johangroth/PLUTO/README.md

#PLUTO --- A WDC65C02 based Single Board Computer ---#

###Links to inspirational projects###
