johangroth/PLUTO/doc/pluto.odt

Pluto ACE

A 65C02 SBC by Johan Groth

## Introduction

This is my first SBC project which is based on a 65C02 MPU. I got inspired building my own computer by finding a paper I wrote in collage about 35 years ago with pretty much the same idea, build a computer from scratch. That work was in turn based on my experiences with my still favourite computer, the Commodore 64 (still got one, now with a 60GB hard drive, thanks to the IDE64 project and an REU thanks to the 1541 Ultimate II+ project).

Back then I didn't have the resources (regulated power supply, oscilloscope, soldering station, a high quality multi meter, etc) and definitely not the money to build one so the paper became a theoretical computer I never built. Now, 35 years later I actually got the resources needed to build one and to my surprise the 65C02 is still in production (thank you WDC) together with the most common support/io ICs, the VIA 65C22 and the ACIA 65C51. Add some static RAM and an EEPROM and you got a computer that can interface with the world through the VIA and be controlled over the serial line via the ACIA.

Another inspiration is a little known computer that saw the light of day in early eighties called the Jupiter ACE. It had the capabilities of a ZX-81, if not less but you didn't need a hammer and a chisel to type anything as it had a rubber membrane keyboard like the ZX Spectrum. What was special with the Jupiter ACE compared to the rest of all 8-bit computer from the eighties was that it didn't use BASIC as its OS, but Forth. That intrigued me a lot back then but all my friends had a Commodore 64 so that is what I got as well.

My original Commodore 64 is long gone, so I bought one from Ebay and it works just fine and IMHO with the IDE64 interface and a modern hard drive it is a nice computer system. It didn't come with any software though (not that I wanted any) so I had to search the internet for assemblers, tools and some games and while doing that I stumbled on the web-site http://6502.org/ which has forums about SBCs, 6502 assembler routines etc, and a Forth forum.

So I thought, why not build something similar to the Jupiter ACE computer. Same MPU, better I/O, more memory, a serial interface, no video though as I don't know anything about video, so for this project composite video or CGA (half VGA) is out of scope from the very beginning. So I started to research how the Jupiter ACE works and found a big snag. The Jupiter ACE is based on a Z80 MPU and I know nothing about that MPU and learning a new hardware architecture is too much of a hassle. So I decided to build an SBC based on a 65C02 and using Forth as it's OS.

Ambitious, yes!

Impossible, no!

# Goals, both hardware and software

Hardware:

- An WDC65C02
- An ACIA (I chose the R65C51AE4 as the WDC65C51 has a hardware bug which makes transmission difficult to implement.)
- One VIA WDC65C21
- 32KB of RAM
- 32KB of ROM
- 16-bit IDE interface
- RTC DS1511Y
- Box to house it. Must be something retro, like a radio from the forties (inspired by the Veronica project).
- VT100 terminal interface.

Software:

- Tali Forth with an integrated full screen editor over serial line, so a fully compliant VT100 terminal that can render Escape sequences will be a requirement.
- PLUTO OS which will use Tali Forth, so for example, creating multiple directories will be something like mkdir “dir1/dir2/dir3”.
- CFS which is the file system IDEDOS project has created. Right now it is bespoke to the IDE64 project but the software is GPL so anyone can use it and it should be possible to adapt it to another hardware platform. I want it so I can exchange files between the PLUTO system and the C64.

Personal:

- Learn a lot more about digital electronics (in some areas relearn what I once knew).
- KiCad because it is free and a Linux version exists.
- 65C02 assembly (I've forgotten so much from my Commodore 64 days).
- Learn Forth

# Architecture

Memory map PLUTO (Thank you Daryl Rictor for the decoding logic!)

Start | End | Description
$0000 | $7EFF | RAM (32K minus 256 bytes)
$7F00 | $7F1F | Decoded I/O Block (32 bytes)
$7F20 | $7F3F | Decoded I/O Block (32 bytes)
$7F40 | $7F5F | Decoded I/O Block (32 bytes)
$7F60 | $7F7F | Decoded I/O Block (32 bytes)
$7F80 | $7F9F | IDE interface (32 bytes)
$7FA0 | $7FBF | Real Time Clock, DS1511Y (32 bytes)
$7FC0 | $7FDF | VIA (32 bytes)
$7FE0 | $7FFF | ACIA (32 bytes)
$8000 | $FFFF | EEPROM (32K)

Memory map ACIA

RS1 | RS0 | R/W | Memory Position | Description
0 | 0 | 0 | $7FE0 | TxD
0 | 0 | 1 | $7FE0 | RxD
0 | 1 | 0 | $7FE1 | Programmed Reset
0 | 1 | 1 | $7FE1 | Read Status Register
1 | 0 | 0 | $7FE2 | Write Command Register
1 | 0 | 1 | $7FE2 | Read Command Register
1 | 1 | 0 | $7FE3 | Write Control Register
1 | 1 | 1 | $7FE3 | Read Control Register

Memory map VIA

Register Number | RS Coding | | | | Register Designation | Description
| RS3 | RS2 | RS1 | RS2 | | Write/Read
0 | 0 | 0 | 0 | 0
1 | 0 | 0 | 0 | 1
2 | 0 | 0 | 1 | 0
3 | 0 | 0 | 1 | 1
4 | 0 | 1 | 0 | 0
5 | 0 | 1 | 0 | 1
6 | 0 | 1 | 1 | 0
7 | 0 | 1 | 1 | 1
8 | 1 | 0 | 0 | 0
9 | 1 | 0 | 0 | 1
A | 1 | 0 | 1 | 0
B | 1 | 0 | 1 | 1
C | 1 | 1 | 0 | 0
D | 1 | 1 | 0 | 1
E | 1 | 1 | 1 | 0
F | 1 | 1 | 1 | 1

RS-232 pin layout

Signal abbreviation | Meaning | Signal direction at DTE UART | Logic | DB-9 pin number (standard) | R6551 (DIP) pin
GND | Signal ground | | | 5 | 1
TxD | Transmitted data | Output | Positive | 3 | 10
RxD | Received data | Input | Positive | 2 | 12
RTS | Request to send | Output | Negative | 7 | 8
CTS | Clear to send | Input | Negative | 8 | 9
DTR | Data terminal ready | Output | Negative | 4 | 11
DSR | Data set ready | Input | Negative | 6 | 17
DCD | Data carrier detect | Input | Negative | 1 | 16

# DOS

From the experience collected with the above prototype software, I went on with the idea of writing a multi layer operating environment (OSS) for the HDD :

- 1st layer : low level routines - init device, read / write sectors - written in assembler
- 2nd layer : disk structure analysis - master boot record -> find the partition table, boot parameter block -> find CFS and its main structures - written in assembler
- 3rd layer : CFS structure navigation - written in assembler.
- 4th layer : small and efficient user services - save / load / execute, navigate in directory tree - written in Forth

# Schematics

# Construction

## PCB

## Mechanical
