johangroth/PLUTO/SBC/pluto.pdf

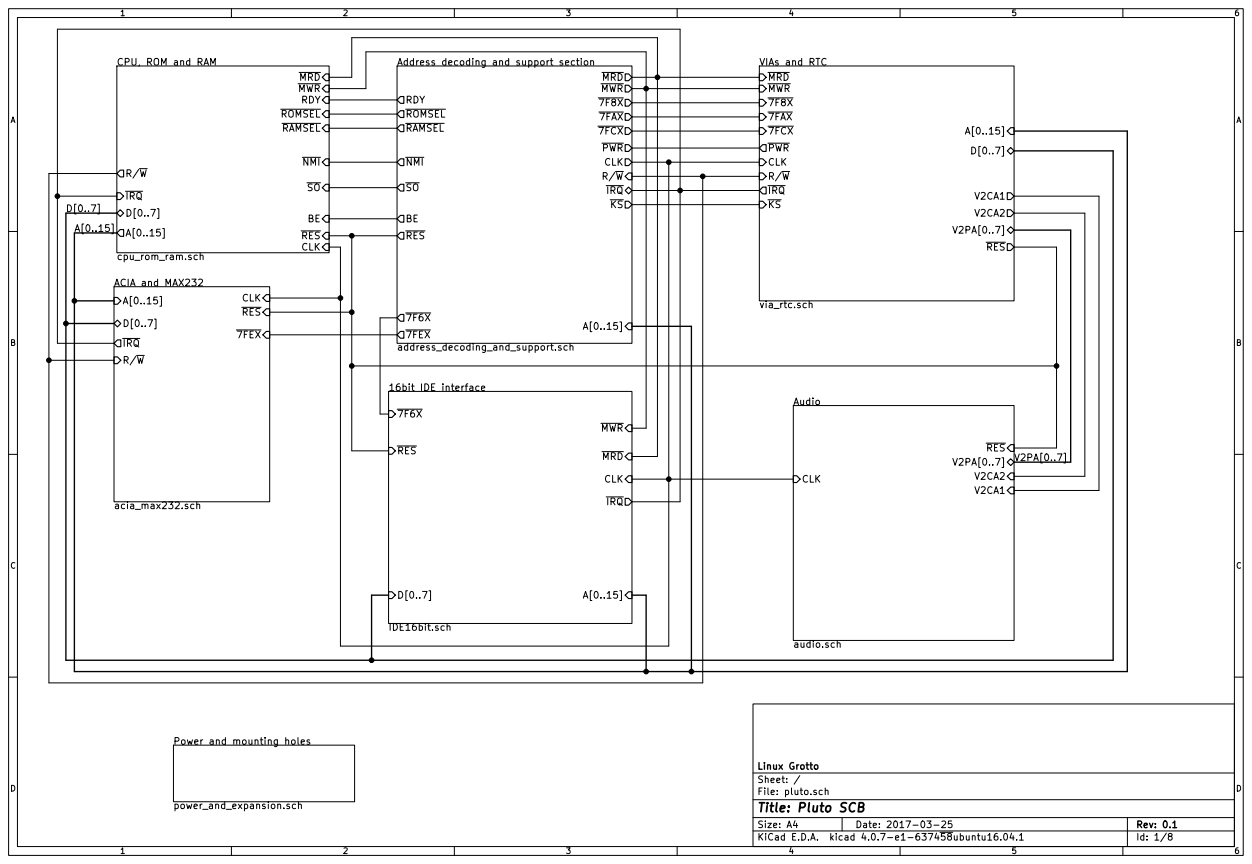
[picture p1: page 1]

CPU, ROM and RAM

Address decoding and support section
RDY RES
ROMSEL
RAMSEL

NMI CLK MRD MWR

Power and mounting holes

File: pluto.sch Sheet: / Linux Grotto

Id: 1/8 Title: Pluto SCB

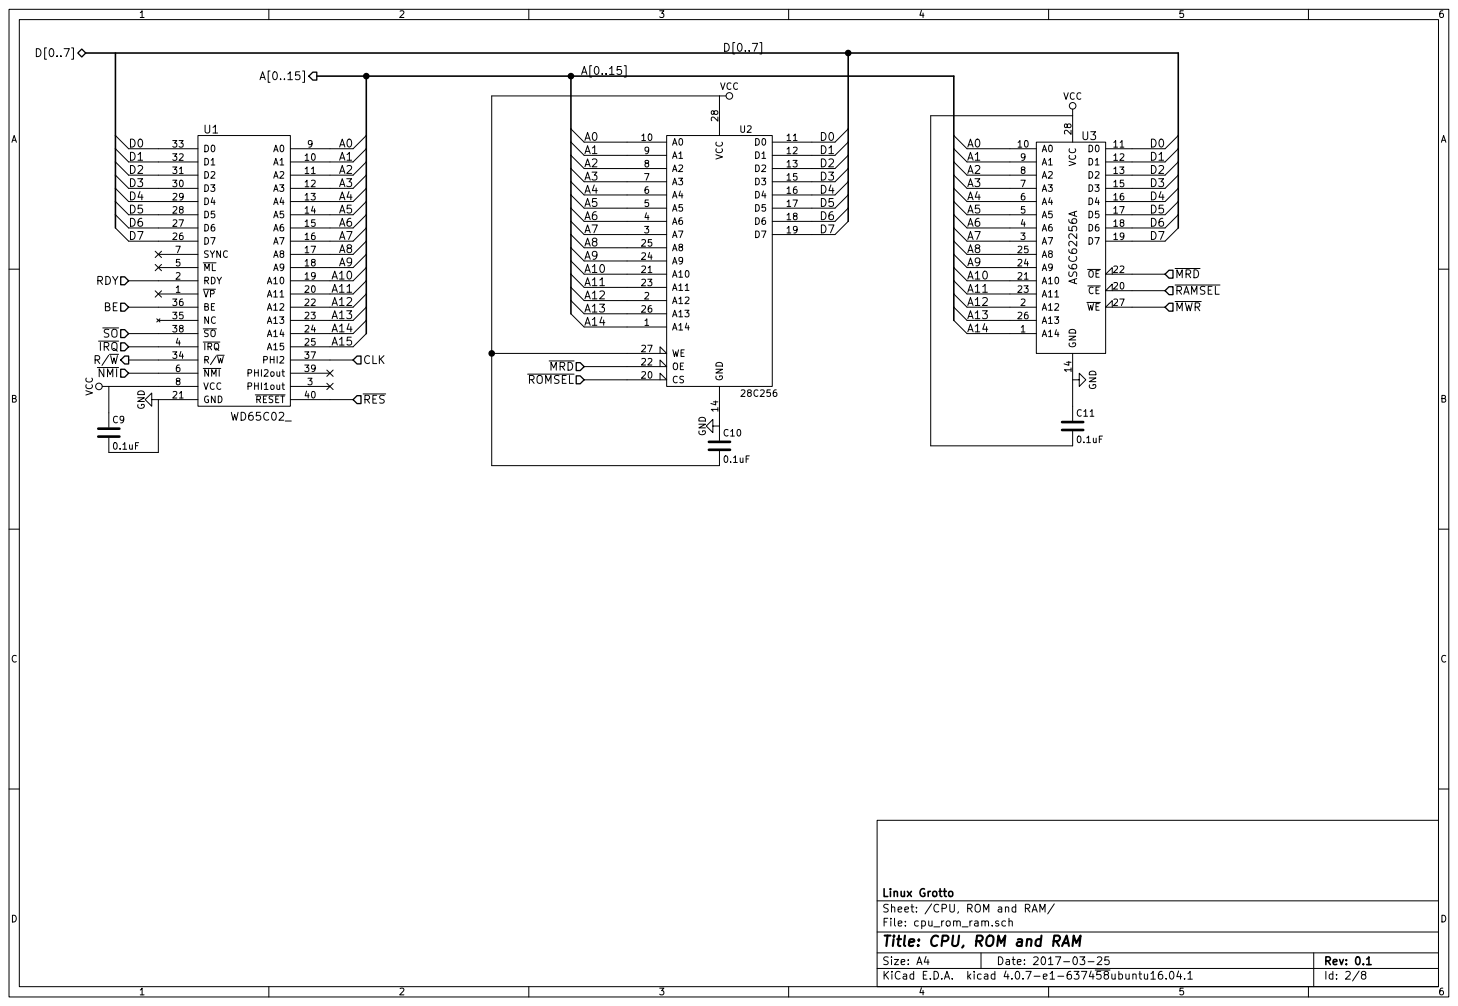
[picture p2: page 2]

Sheet: /CPU, ROM and RAM/ Linux Grotto

File: cpu_rom_ram.sch
Id: 2/8 Title: CPU, ROM and RAM

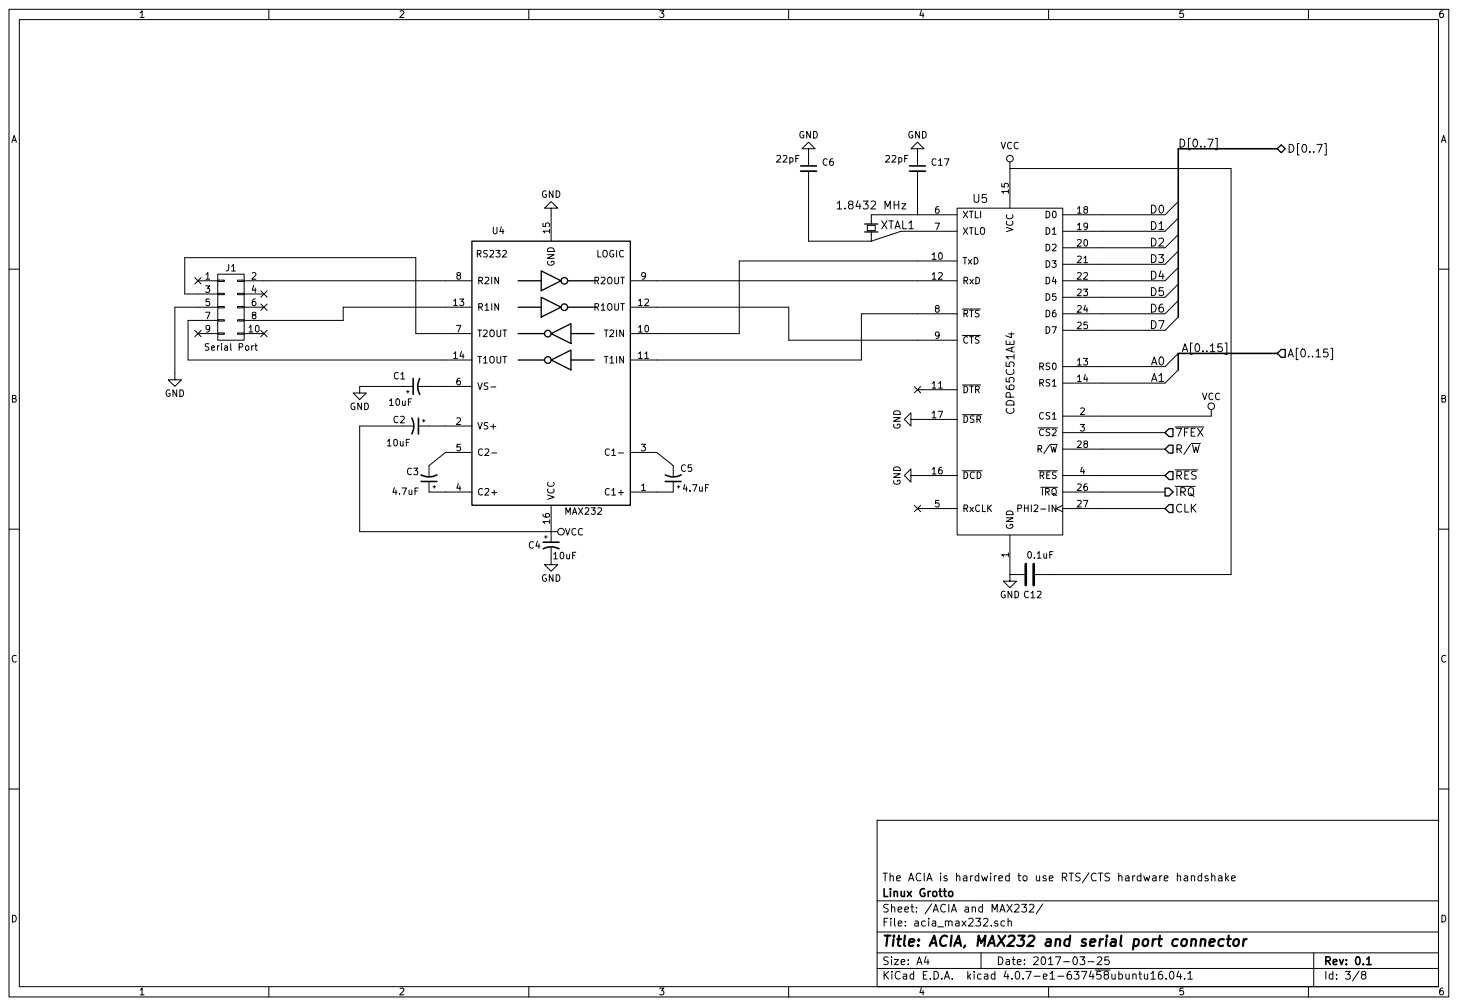
[picture p3: page 3]

1 CS1 2 CS2 3 RES 4 RxCLK 5 XTLI 6 XTLO 7 RTS 8 CTS 9 TxD 10 D2 20 DTR 11 D3 21 RxD 12 D4 22 RS0 13 D5 23 RS1 14 D6 24 VCC 15 D7 25 DCD 16

The ACIA is hardwired to use RTS/CTS hardware handshake GND

File: acia_max232.sch Sheet: /ACIA and MAX232/ Linux Grotto

Id: 3/8 Title: ACIA, MAX232 and serial port connector

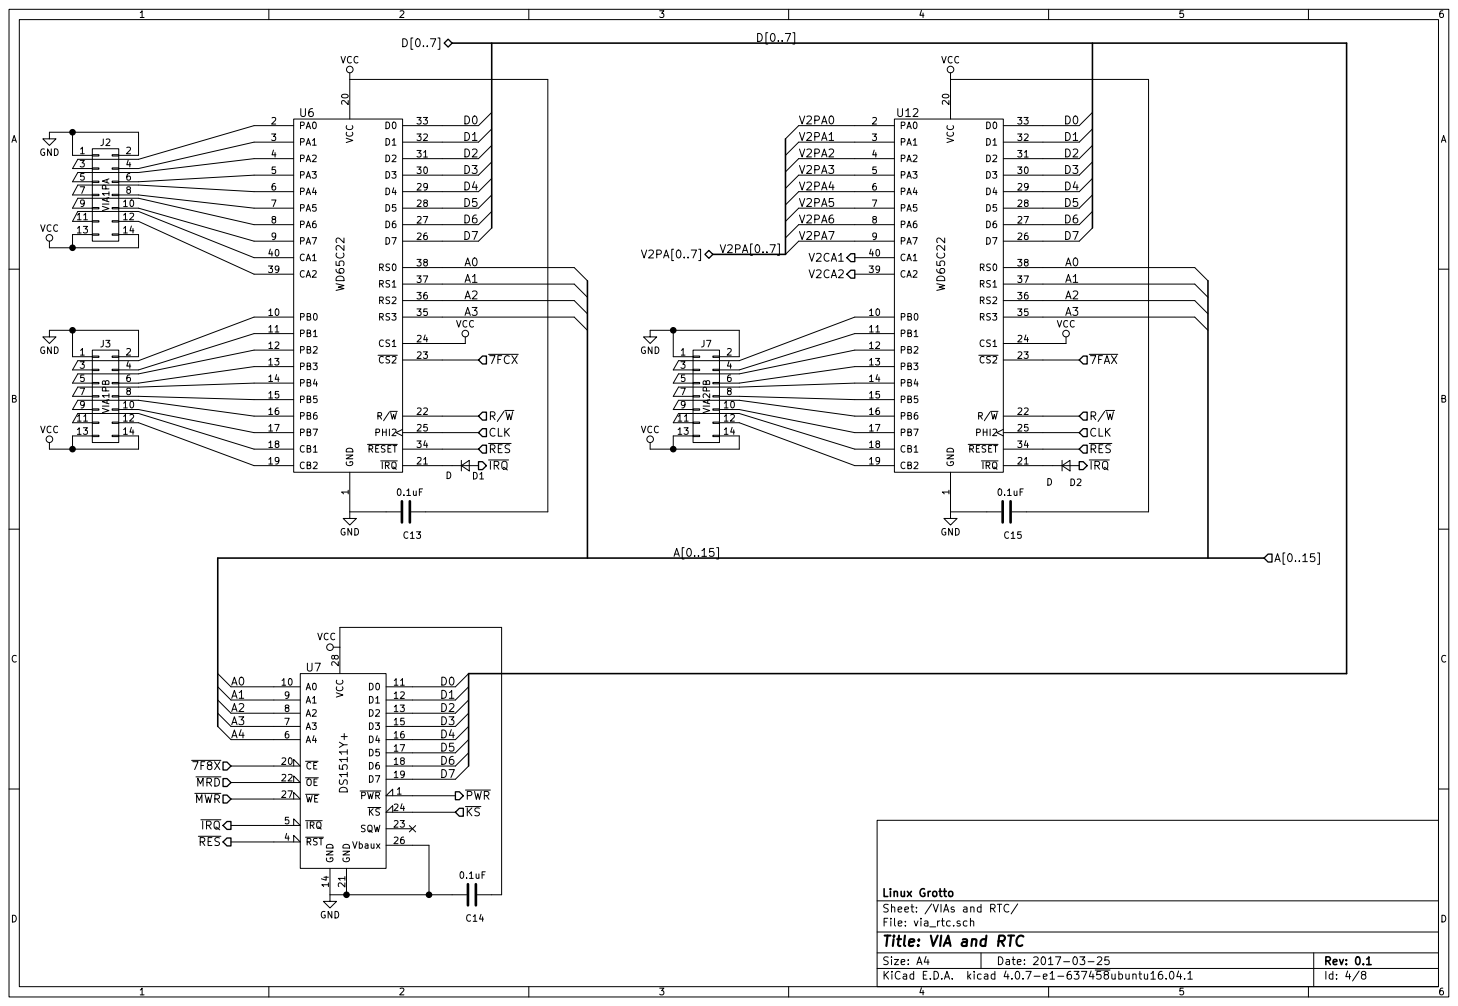
[picture p4: page 4]

Id: 4/8 Title: VIA and RTC

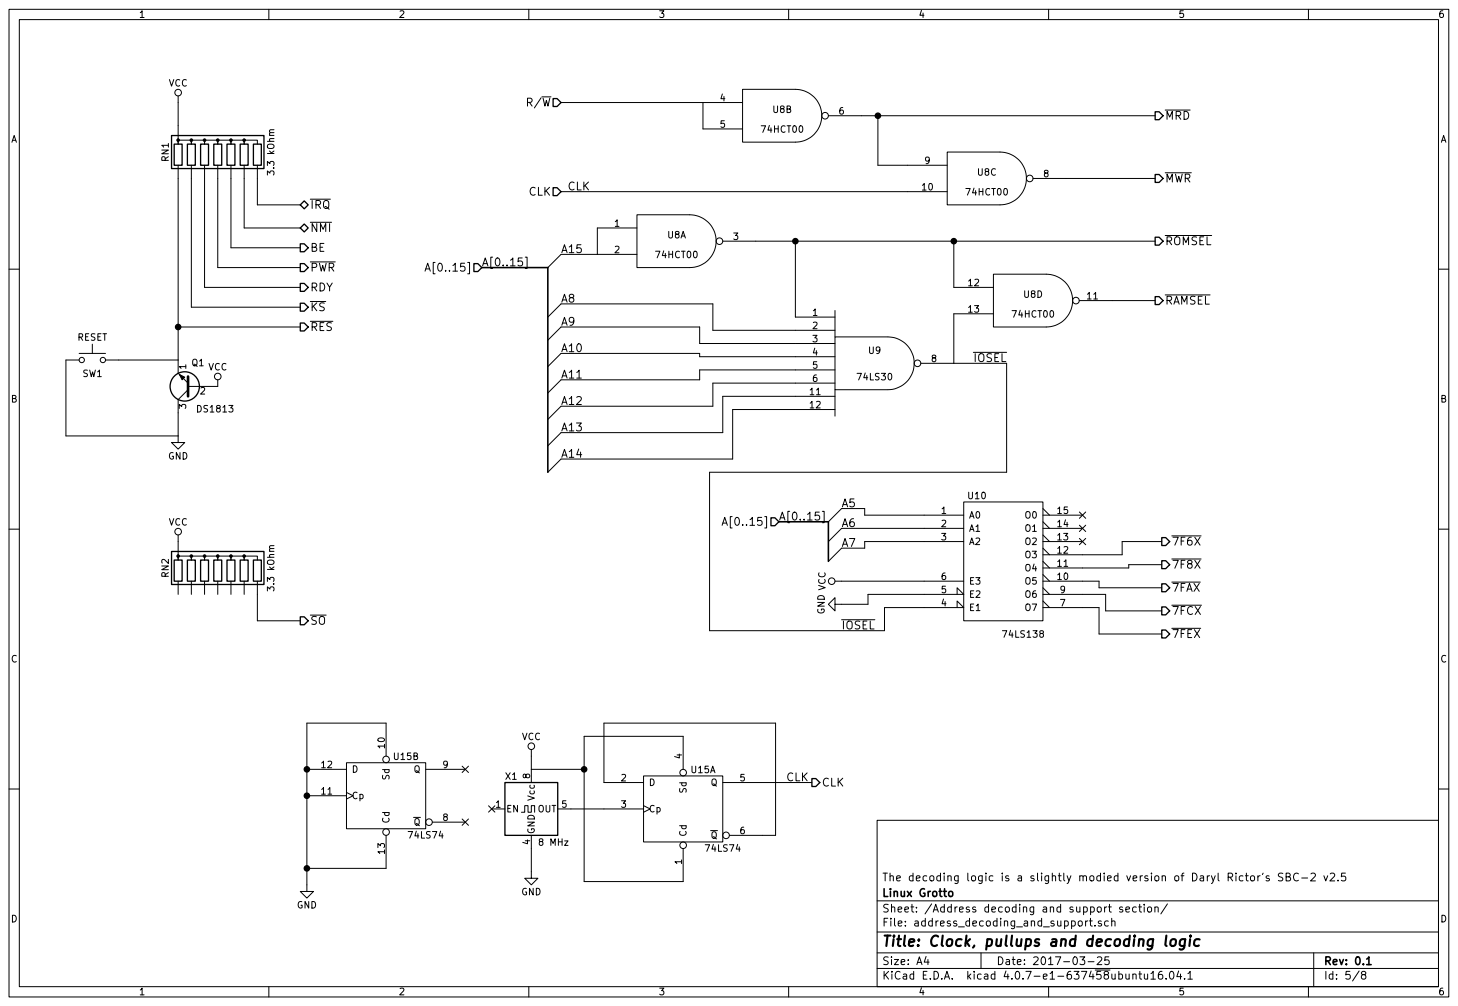
[picture p5: page 5]

3 Q1DS1813 VCC SW1 RESET GND VCC GND Cd

The decoding logic is a slightly modied version of Daryl Rictor's SBC-2 v2.5
Sheet: /Address decoding and support section/ Linux Grotto

File: address_decoding_and_support.sch
Id: 5/8 Title: Clock, pullups and decoding logic

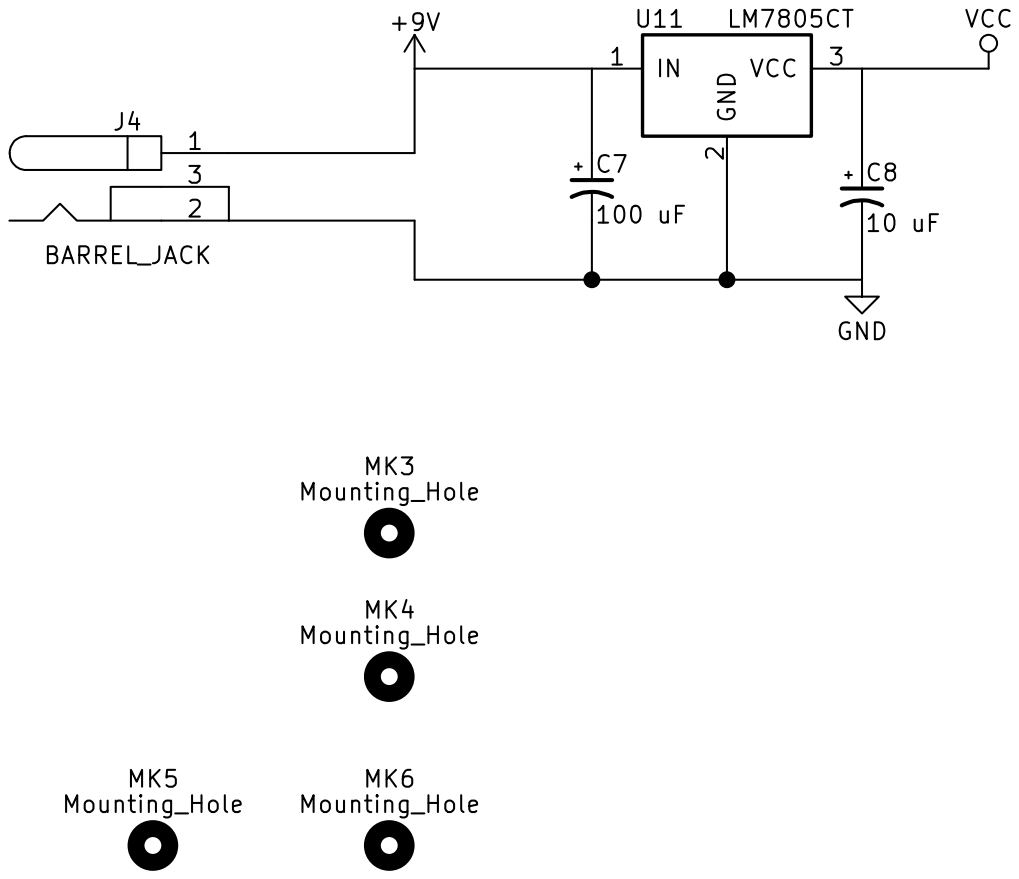
[picture p6: page 6]

Sheet: /Power and mounting holes/ Linux Grotto

File: power_and_expansion.sch
Id: 6/8 Title: Power supply and mounting holes

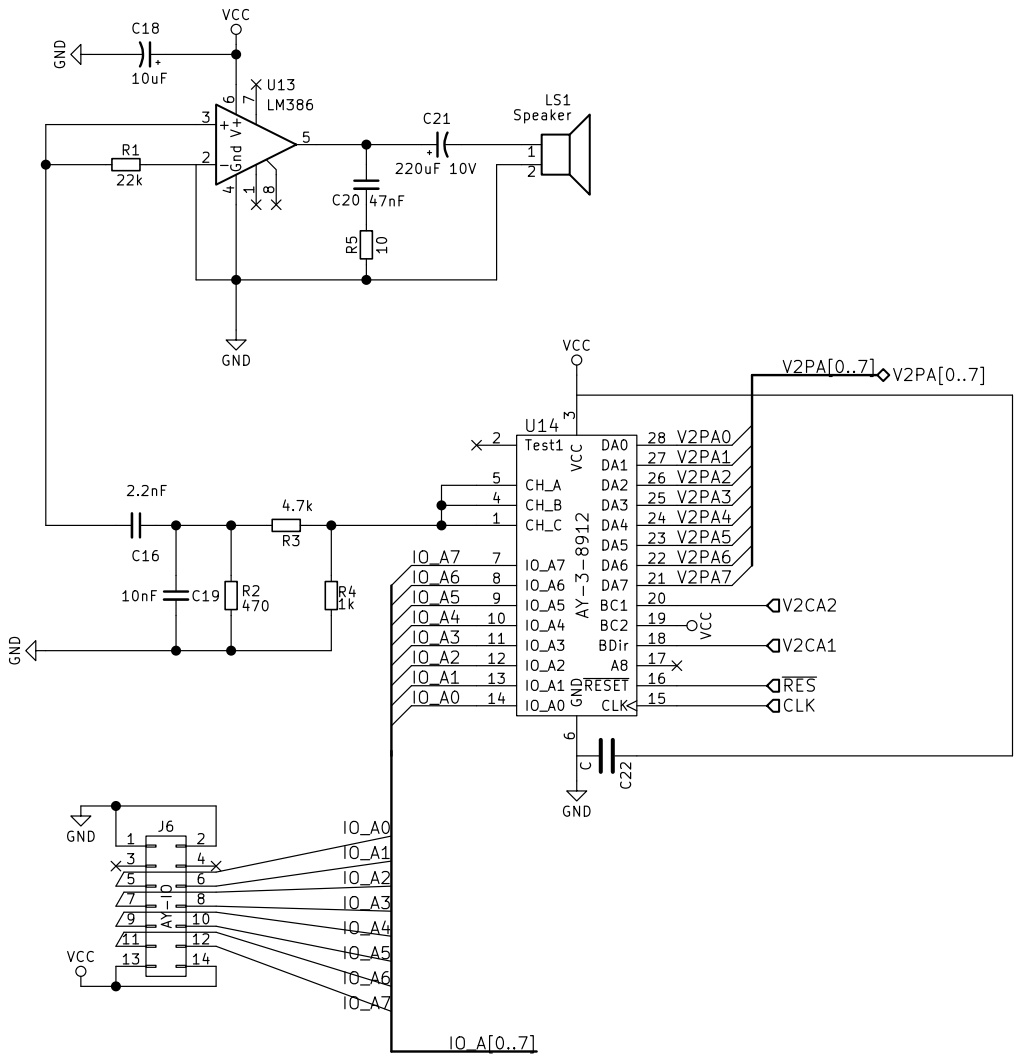
[picture p7: page 7]

File: audio.sch Sheet: /Audio/
Id: 7/8 Title: Audio

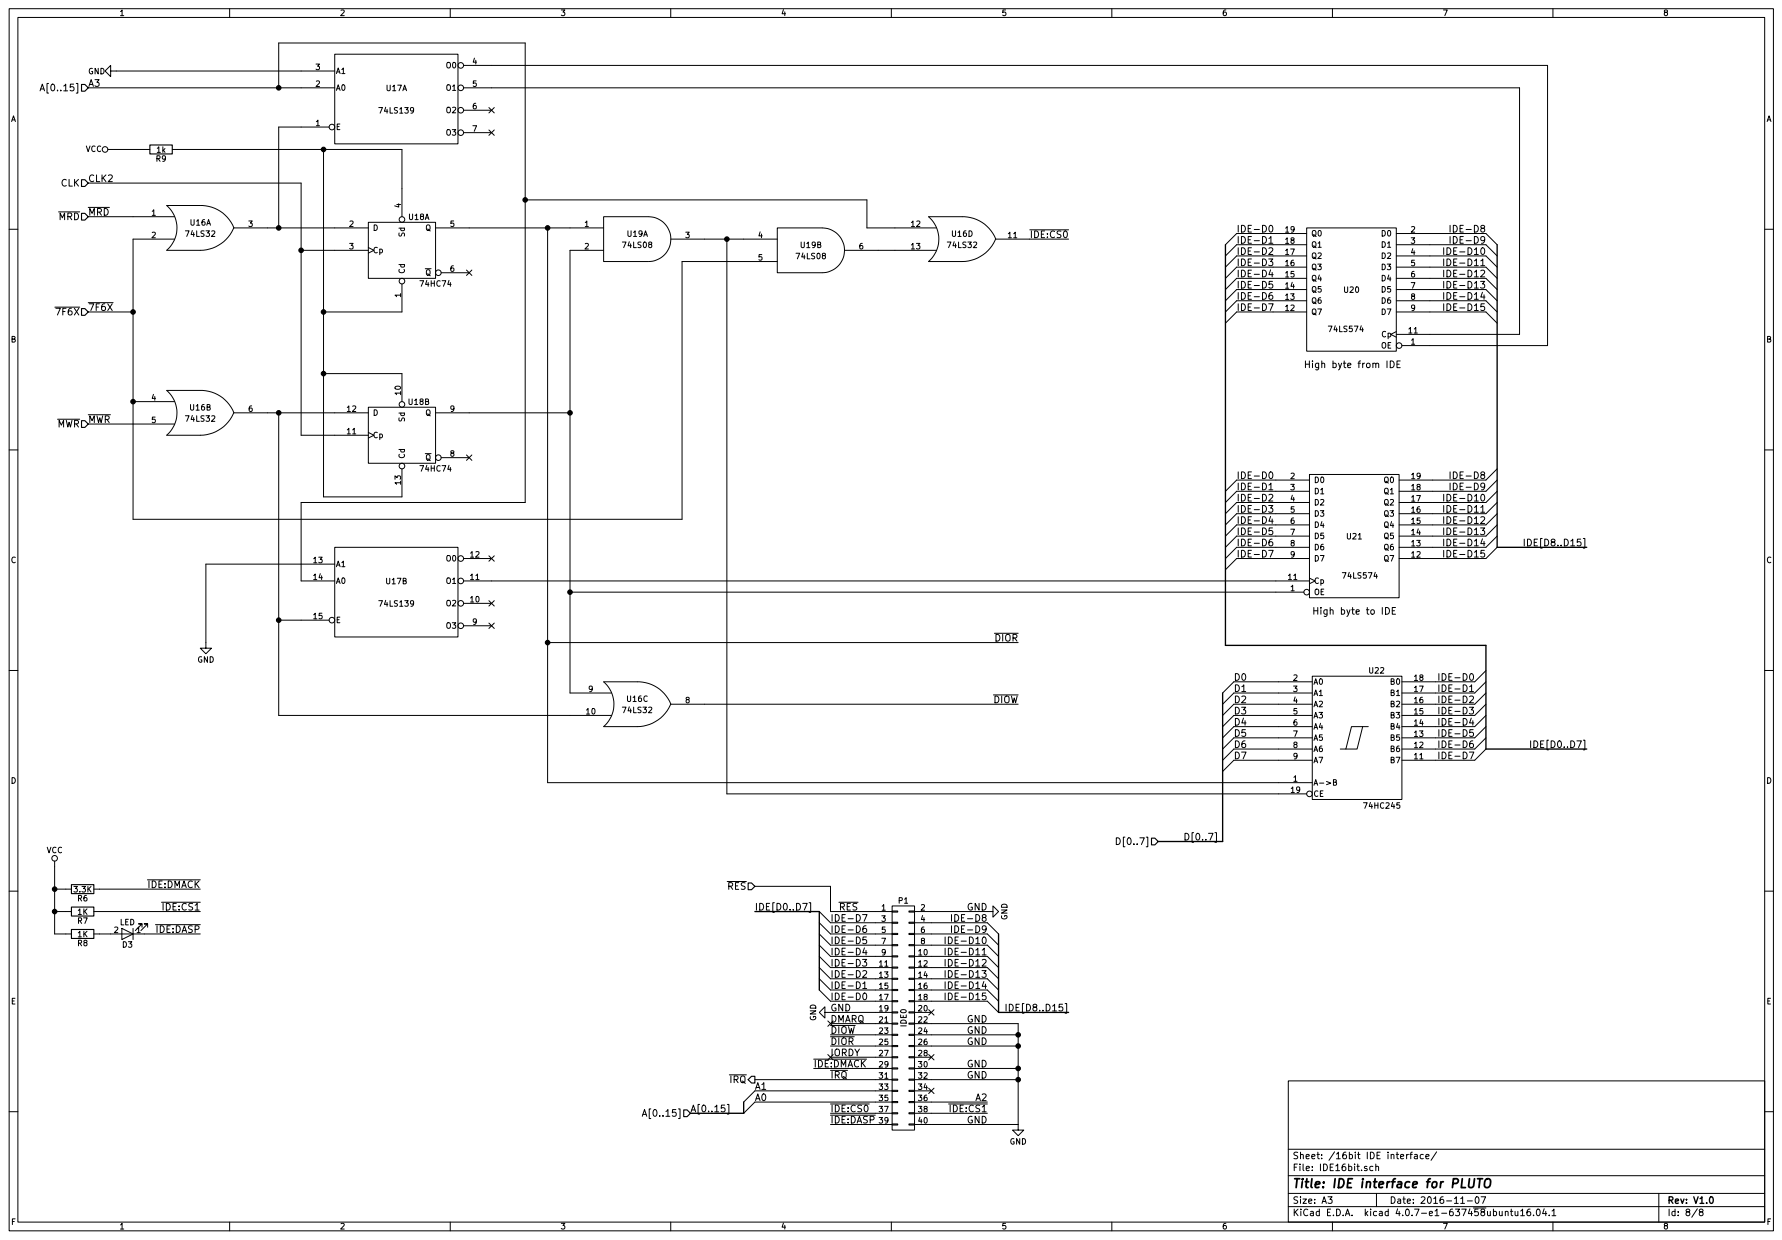
[picture p8: page 8]

IDE:CS0 DIOR
High byte from IDE High byte to IDE

Id: 8/8 Title: IDE interface for PLUTO
