johangroth/PLUTO/(list of files, drawings)

Other design files:
SBC/pluto.dsn
