johangroth/PLUTO/SW/PlutoDos/pluto_kernel.asm

;
;
;***************************************************
;* S/O/S SyMon III (c)1990,2007 By Brian M. Phelps *
;*                                                 *
;*         BIOS, Monitor, Micro-assembler          *
;*           For the 6502/65c02 family             *
;*         of microprocessor units (MPU)           *
;*                                                 *
;*   Includes text editor, text and byte string    *
;*  search utility, data upload/download utility   *
;*                                                 *
;*              Version 06/07/07                   *
;*                                                 *
;*          (Requires 8kb of memory)               *
;***************************************************
;

;16 byte buffer
    SRCHBUFF = $00F0    ;16 bytes ($F0-$FF) (notice that this variable MUST be expressed as a 16 bit address
;                        even though it references a zero-page address)
;
;Keystroke input buffer address:
    KEYBUFF  = $0200    ;256 bytes: ($200-$2FF) keystrokes (data from ACIA) are stored here
                       ; by SyMon's IRQ service routine.

;
;
;Interrupt vectors. User can change the interrupt vector by putting a new value at this address.
    INTERRUPTVECTORS    = $0300
    NMIVECTOR           = INTERRUPTVECTORS
    IRQVECTOR           = INTERRUPTVECTORS+2
    BREAKVECTOR         = INTERRUPTVECTORS+4
    VIATIMER1VECTOR     = INTERRUPTVECTORS+6
    VIATIMER2VECTOR     = INTERRUPTVECTORS+8
    ACIAVECTOR          = INTERRUPTVECTORS+10
;
;
;***************
;* Subroutines *
;***************
;
;ASC2BN subroutine: Convert 2 ASCII HEX digits to a binary (byte) value.
; Enter: ACCUMULATOR = high digit, Y-REGISTER = low digit
; Returns: ACCUMULATOR = binary value
ASC2BN  .proc
        PHA           ;Save high digit on STACK
        TYA           ;Copy low digit to ACCUMULATOR
        JSR  BINARY   ;Convert digit to binary nybble: result in low nybble
        STA  TEMP     ;Store low nybble
        PLA           ;Pull high digit from STACK
        JSR  BINARY   ;Convert digit to binary nybble: result in low nybble
        ASL        ;Move low nybble to high nybble
        ASL
        ASL
        ASL
        ORA  TEMP     ;OR high nybble with stored low nybble
        RTS           ;Done ASC2BN subroutine, RETURN
BINARY:
        SEC           ;Clear BORROW
        SBC  #$30     ;Subtract $30 from ASCII HEX digit
        CMP  #$0A     ;GOTO BNOK IF result < $0A
        BCC  BNOK
        SBC  #$07     ; ELSE, subtract $07 from result
BNOK:
        RTS           ;Done BINARY subroutine, RETURN
        .pend
;
;ASCTODEC subroutine: convert ASCII DECIMAL digits to BCD
ASCTODEC    .proc         ;Initialize (zero) BCD digit input buffer:
        STZ  DEC0AND1 ; two most significant BCD digits
        STZ  DEC2AND3
        STZ  DEC4AND5
        STZ  DEC6AND7
        STZ  DEC8AND9 ; two least significant BCD digits
        LDX  BUFIDX   ;Read number of digits entered: ASCII digit buffer index
        BEQ  A2DDONE  ;GOTO A2DDONE IF BUFIDX = 0: no digits were entered
        LDY  #$05     ; ELSE, Initialize BCD input buffer index: process up to 5 BCD bytes (10 digits)
ATODLOOP:
        JSR  A2DSUB   ;Read ASCII digit then convert to BCD
        STA  DPHANTOM,Y ;Write BCD digit to indexed buffer location (index always > 0)
        JSR  A2DSUB   ;Read ASCII digit then convert to BCD
        ASL        ;Make this BCD digit the more significant in the BCD byte
        ASL
        ASL
        ASL
        ORA  DPHANTOM,Y ;OR with the less significant digit
        STA  DPHANTOM,Y ;Write BCD byte to indexed buffer location (index always > 0)
        DEY           ;Decrement BCD input buffer index
        BNE  ATODLOOP ;GOTO ATODLOOP IF buffer index <> 0: there is room to process another digit
A2DDONE:
        RTS           ; ELSE, done ASCTODEC, RETURN
        .pend

;Read indexed ASCII DECIMAL digit from text buffer then convert digit to 4 bit BCD
A2DSUB  .proc
        TXA           ;GOTO A2DCONV IF digit buffer index <> 0: there are more digits to process
        BNE  A2DCONV
        PLA           ; ELSE, pull return address from STACK
        PLA
        RTS           ;Done ASCTODEC, RETURN
A2DCONV:
        LDA  INBUFF-1,X ;Read indexed ASCII DECIMAL digit
        SEC           ;Subtract ASCII "0" from ASCII DECIMAL digit: convert digit to BCD
        SBC  #$30
        DEX           ;Decrement ASCII digit buffer index
        RTS           ;A2DSUB done, RETURN
        .pend
;
;BCDOUT subroutine: convert 10 BCD digits to ASCII DECIMAL digits then send result to terminal.
;Leading zeros are supressed in the displayed result.
;Call with 10 digit (5 byte) BCD value contained in variables DEC0AND1 through DEC8AND9:
;DEC0AND1 ($E5) Two most significant BCD digits
;DEC2AND3 ($E6)
;DEC4AND5 ($E7)
;DEC6AND7 ($E8)
;DEC8AND9 ($E9) Two least significant BCD digits
BCDOUT  .proc
        LDX  #$00     ;Initialize BCD output buffer index: point to MSB
        LDY  #$00     ;Initialize leading zero flag: no non-zero digits have been processed
BCDOUTL
        LDA  DEC0AND1,X ;Read indexed byte from BCD output buffer
        LSR        ;Shift high digit to low digit, zero high digit
        LSR
        LSR
        LSR
        JSR  BCDTOASC ;Convert BCD digit to ASCII DECIMAL digit, send digit to terminal
        LDA  DEC0AND1,X ;Read indexed byte from BCD output buffer
        AND  #$0F     ;Zero the high digit
        JSR  BCDTOASC ;Convert BCD digit to ASCII DECIMAL digit, send digit to terminal
        INX           ;Increment BCD output buffer index
        CPX  #$05
        BNE  BCDOUTL  ;LOOP back to BCDOUTL IF output buffer index <> 5
        CPY  #$00
        BNE  BCDOUTDN ; ELSE, GOTO BCDOUTDN IF any non-zero digits were processed
        LDA  #$30     ; ELSE, send "0" to terminal
        JSR  COUT
BCDOUTDN
        RTS           ;Done BCDOUT subroutine, RETURN
        .pend

;BCDTOASC subroutine:
; convert BCD digit to ASCII DECIMAL digit, send digit to terminal IF it's not a leading zero
BCDTOASC    .proc
        BNE  NONZERO  ;GOTO NONZERO IF BCD digit <> 0
        CPY  #$00     ; ELSE, GOTO BTADONE IF no non-zero digits have been processed
        BEQ  BTADONE  ;  (supress output of leading zeros)
NONZERO
        INY           ; ELSE, indicate that a non-zero digit has been processed (Y REGISTER <> 0)
        CLC           ;Add ASCII "0" to digit: convert BCD digit to ASCII DECIMAL digit
        ADC  #$30
        JSR  COUT     ;Send converted digit to terminal
BTADONE
        RTS           ;Done BCDTOASC subroutine, RETURN
        .pend
;
;
;BEEP subroutine: Send ASCII [BELL] to terminal
BEEP    .proc
        PHA           ;Save ACCUMULATOR on STACK
        LDA  #$07     ;Send ASCII [BELL] to terminal
        JSR  COUT
        PLA           ;Restore ACCUMULATOR from STACK
        RTS           ;Done BEEP subroutine, RETURN
        .pend
;
;BN2ASC subroutine: Convert byte in ACCUMULATOR to two ASCII HEX digits.
; Returns: ACCUMULATOR = high digit, Y-REGISTER = low digit
BN2ASC  .proc
        TAX          ;Copy ACCUMULATOR to X-REGISTER
        AND  #$F0     ;Mask (zero) low nybble
        LSR        ;Move high nybble to low nybble: high nybble now = 0
        LSR
        LSR
        LSR
        JSR  ASCII    ;Convert nybble to an ASCII HEX digit
        PHA           ;Save high digit on STACK
        TXA           ;Restore ACCUMULATOR from X-REGISTER
        AND  #$0F     ;Mask (zero) high nybble
        JSR  ASCII    ;Convert nybble to an ASCII HEX digit
        TAY           ;Copy low digit to Y-REGISTER
        PLA           ;Pull high digit from STACK to ACCUMULATOR
        RTS           ;Done BN2ASC subroutine, RETURN
        .pend

ASCII   .proc
        CMP  #$0A     ;GOTO ASOK IF nybble < $A
        BCC  ASOK
        CLC           ; ELSE, clear CARRY
        ADC  #$07     ;ADD $07
ASOK:
        ADC  #$30     ;ADD $30
        RTS           ;Done BN2ASC or ASCII subroutine, RETURN
        .pend
;
;BSOUT subroutine: send [BACKSPACE] to terminal
BSOUT   .proc
        LDA  #$08     ;Send [BACKSPACE] to terminal
        BRA  COUT     ; then done BSOUT subroutine, RETURN
        .pend

;
;CHIN subroutine: Wait for a keystroke, return with keystroke in ACCUMULATOR
CHIN    .proc
        STX  TEMP     ;Save X REGISTER
CHINLOOP:
        CLI           ;Enable external IRQ response
        LDA  INCNT    ;(Keystroke buffer input counter)
        CMP  OUTCNT   ;(Keystroke buffer output counter)
        BEQ  CHIN     ;LOOP back to CHIN IF INCNT = OUTCNT: there are no keystrokes in buffer
        LDX  OUTCNT   ; ELSE, read indexed keystroke from buffer
        LDA  KEYBUFF,X
        INC  OUTCNT   ;Remove keystroke from buffer
        LDX  TEMP     ;Restore X REGISTER
        RTS           ;Done CHIN subroutine, RETURN
        .pend

;
;CHREG subroutine: Display HEX byte value in ACCUMULATOR, request HEX byte input from terminal
CHREG   .proc
        JSR  PRBYTE   ;Display HEX value of ACCUMULATOR
        JSR  SPC      ;Send [SPACE] to terminal
        JMP  HEXIN2   ;Request HEX byte input from terminal (result in ACCUMULATOR)
                      ; then done CHREG subroutine, RETURN
        .pend

;
;COUT subroutines: Send byte in ACCUMULATOR to terminal (1,2 or 3 times)
COUT3:  .proc
        JSR  COUT     ;(Send byte 3 times)
        .pend

COUT2:  .proc
        JSR  COUT     ;(Send byte 2 times)
        .pend

COUT    .proc
        PHA           ;Save ACCUMULATOR on STACK
COUTL:  LDA  SIOSTAT  ;Read ACIA status register
        AND  #$10     ;Isolate transmit data register status bit
        BEQ  COUTL    ;LOOP back to COUTL IF transmit data register is full
        PLA           ; ELSE, restore ACCUMULATOR from STACK
        STA  SIODAT   ;Write byte to ACIA transmit data register
        RTS           ;Done COUT subroutine, RETURN
        .pend

;
;DECINPUT subroutine: request 1 to 10 DECIMAL digits from terminal. Result is
; stored in zero-page address INBUFF through (INBUFF + $0A)
;Setup RDLINE subroutine parameters:
DECINPUT    .proc
        LDA  #$FF     ;  Allow only valid ASCII DECIMAL digits to be entered:
        STA  LOKOUT   ;   variable LOKOUT = $FF
        LDY  #INBUFF  ;  Y-REGISTER = buffer address low byte
        LDA  #$00     ;  ACCUMULATOR = buffer address high byte
        LDX  #$0A     ;  X-REGISTER = maximum number of digits allowed
        JSR  RDLINE   ;Request ASCII DECIMAL digit(s) input from terminal
        RTS           ;Done DECINPUT subroutine, RETURN
        .pend

;
;DECINDEX subroutine: decrement 16 bit system variable INDEX,INDEXH
DECINDEX    .proc
        LDA  INDEX
        BNE  DECDONE
        DEC  INDEXH
DECDONE:
        DEC  INDEX
        RTS           ;Done DECINDEX subroutine, RETURN
        .pend

;
;DOLLAR subroutine: Send "$" to terminal
;CROUT subroutines: Send CR,LF to terminal (1 or 2 times)
DOLLAR  .proc
        PHA           ;Save ACCUMULATOR on STACK
        LDA  #'$'     ;Send "$" to terminal
        BRA  SENDIT   ;GOTO SENDIT
                                  .pend

;Send CR,LF to terminal 2 times
CR2     .proc
        JSR  CROUT    ;Send CR,LF to terminal
        .pend
;Send CR,LF to terminal 1 time
CROUT   .proc
        PHA           ;Save ACCUMULATOR
        LDA  #$0D     ;Send [RETURN] to terminal
        JSR  COUT
        LDA  #$0A     ;Send [LINEFEED] to terminal
        .pend

SENDIT  .proc
        JSR  COUT
        PLA           ;Restore ACCUMULATOR from STACK
        RTS           ;Done CROUT or DOLLAR subroutine, RETURN
        .pend

;
;DELAY1 subroutine: short delay loop, duratiion is (1 * DELLO)
;DELAY2 subroutine: medium delay loop, duration is (DELHI * DELLO)
DELAY1  .proc
        LDX  #$01     ;Preset delay multiplier to 1
        BRA  ITER
DELAY2
        LDX  DELHI    ;Read delay multiplier variable
ITER
        LDY  DELLO    ;Read delay duration variable
WAIT
        DEY           ;Decrement duration counter
        BNE  WAIT     ;LOOP back to WAIT IF duration <> 0
        DEX           ; ELSE, decrement multiplier
        BNE  ITER     ;LOOP back to ITER IF multiplier <> 0
        RTS           ; ELSE, done DELAYn subroutine, RETURN
        .pend

;HEXIN subroutines: Request 1 to 4 ASCII HEX digit input from terminal
; then convert digits into a binary (byte or word) value
;IF 1 OR 2 digits are REQUESTED, returns byte in ACCUMULATOR
;IF 3 OR 4 digits are REQUESTED, returns word in variable INDEX (low byte),INDEXH (high byte)
;Variable SCNT will contain the number of digits entered
HEXIN2  .proc
        LDA  #$02     ;Request 2 ASCII HEX digits from terminal: 8 bit value
        BRA  HEXIN    ;GOTO HEXIN: always branch
        .pend

HEXIN4  .proc
        LDA  #$04     ;Request 4 ASCII HEX digits from terminal: 16 bit value
        .pend

HEXIN   .proc
        STA  INQTY    ;Store number of digits to allow: value = 1 to 4 only
        JSR  DOLLAR   ;Send "$" to terminal
;Setup RDLINE subroutine parameters:
        LDA  #$80     ;  Allow only valid ASCII HEX digits to be entered:
        STA  LOKOUT   ;   make variable LOKOUT <> 0
        LDA  #$00     ;  ACCUMULATOR = buffer address high byte
        LDY  #INBUFF  ;  Y-REGISTER = buffer address low byte
        LDX  INQTY    ;  X-REGISTER = maximum number of digits allowed
        JSR  RDLINE   ;Request ASCII HEX digit(s) input from terminal
        STX  SCNT     ;Save number of digits entered to SCNT
        LDA  INQTY    ;GOTO JUST4 IF 4 digits were REQUESTED
        CMP  #$04
        BEQ  JUST4
        CMP  #$03     ; ELSE, GOTO JUST3 IF 3 digits were REQUESTED
        BEQ  JUST3
        CPX  #$00     ; ELSE, GOTO IN2 IF 0 OR 2 digits were entered
        BEQ  IN2
        CPX  #$02
        BEQ  IN2
        JSR  JUST4.JUSTBYTE ; ELSE, move digit from INBUFF to INBUFF+1, write "0" to INBUFF
IN2:
        LDA  INBUFF   ;Convert 2 ASCII HEX digits in INBUFF(high digit),
        LDY  INBUFF+1 ; INBUFF+1(low digit) to a binary value,
        JMP  ASC2BN   ; (result in ACCUMULATOR) then RETURN (done HEXIN subroutine)
JUST3:
        CPX  #$00     ;GOTO IN3 IF 0 OR 3 digits were entered
        BEQ  IN3
        CPX  #$03
        BEQ  IN3
        CPX  #$02     ; ELSE, GOTO SHFT3 IF 2 digits were entered
        BEQ  SHFT3
        JSR  JUST4.JUSTBYTE ; ELSE, move digit from INBUFF to INBUFF+1, write "0" to INBUFF
SHFT3:
        JSR  JUST4.SHIFT    ;Move digits from INBUFF+1 to INBUFF+2, INBUFF to INBUFF+1
IN3:
        LDA  #$30     ;Convert 2 ASCII HEX digits, "0"(high digit),
        LDY  INBUFF   ; INBUFF(low digit) to a binary value,
        JSR  ASC2BN   ; result in ACCUMULATOR
        STA  INDEXH   ;Store in variable INDEXH(high byte)
        LDA  INBUFF+1 ;Convert 2 ASCII HEX digits in INBUFF+1(high digit),
        LDY  INBUFF+2 ; INBUFF+2(low digit) to a binary value,
        JSR  ASC2BN   ; result in ACCUMULATOR
        STA  INDEX    ;Store in variable INDEX(low byte)
        RTS           ;Done HEXIN subroutine, RETURN
        .pend

JUST4   .proc
        CPX  #$00     ;GOTO IN4 IF 0 OR 4 digits were entered
        BEQ  IN4
        CPX  #$04
        BEQ  IN4
        CPX  #$03     ; ELSE, GOTO X3 IF 3 digits were entered
        BEQ  X3
        CPX  #$02     ; ELSE, GOTO X2 IF 2 digits were entered
        BEQ  X2
        JSR  JUSTBYTE ; ELSE, move digit from INBUFF to INBUFF+1, write "0" to INBUFF
X2:
        JSR  SHIFT    ;Move digits from INBUFF+1 to INBUFF+2, INBUFF to INBUFF+1
X3:
        LDA  INBUFF+2 ;Move digits from INBUFF+2 to INBUFF+3
        STA  INBUFF+3
        JSR  SHIFT    ;Move digits from INBUFF+1 to INBUFF+2, INBUFF to INBUFF+1
IN4:    LDA  INBUFF   ;Convert 2 ASCII HEX digits in INBUFF(high digit),
        LDY  INBUFF+1 ; INBUFF+1(low digit) to a binary value,
        JSR  ASC2BN   ; result in ACCUMULATOR
        STA  INDEXH   ;Store in variable INDEXH(high byte)
        LDA  INBUFF+2 ;Convert 2 ASCII HEX digits in INBUFF+2(high digit),
        LDY  INBUFF+3 ; INBUFF+3(low digit) to a binary value,
        JSR  ASC2BN   ; result in ACCUMULATOR
        STA  INDEX    ;Store in variable INDEX(low byte)
        RTS           ;Done HEXIN subroutine, RETURN
SHIFT:
        LDA  INBUFF+1 ;Move digit from INBUFF+1 to INBUFF+2
        STA  INBUFF+2
JUSTBYTE
        LDA  INBUFF   ;Move digit from INBUFF to INBUFF+1
        STA  INBUFF+1
        LDA  #$30     ;Write "0" to INBUFF
        STA  INBUFF
        RTS           ;Done SHIFT or JUSTBYTE subroutine, RETURN
        .pend

;
;
;HEXOUT subroutine: convert 8 HEX digits to ASCII HEX digits then send result to terminal.
;Leading zeros are supressed in the displayed result.
;Call with 8 digit (4 byte) HEX value contained in variables HEX0AND1 through HEX6AND7:
;HEX0AND1 Two most significant HEX digits
;HEX2AND3
;HEX4AND5
;HEX6AND7 Two least significant HEX digits
HEXOUT  .proc
        LDX  #$00     ;Initialize HEX output buffer index: point to MSB
        LDY  #$00     ;Initialize leading zero flag: no non-zero digits have been processed
HEXOUTL:
        LDA  HEX0AND1,X ;Read indexed byte from HEX output buffer
        LSR        ;Shift high digit to low digit, zero high digit
        LSR
        LSR
        LSR
        JSR  HEXTOASC ;Convert HEX digit to ASCII HEX digit, send digit to terminal
        LDA  HEX0AND1,X ;Read indexed byte from HEX output buffer
        AND  #$0F     ;Zero the high digit
        JSR  HEXTOASC ;Convert HEX digit to ASCII HEX digit, send digit to terminal
        INX           ;Increment HEX output buffer index
        CPX  #$04
        BNE  HEXOUTL  ;LOOP back to HEXOUTL IF output buffer index <> 4
        CPY  #$00
        BNE  HEXOUTDN ; ELSE, GOTO HEXOUTDN IF any non-zero digits were processed
        LDA  #$30     ; ELSE, send "0" to terminal
        JSR  COUT
HEXOUTDN:
        RTS           ;Done HEXOUT subroutine, RETURN
        .pend

;
;HEXTOASC subroutine:
; convert HEX digit to ASCII HEX digit then send digit to terminal IF it's not a leading zero
HEXTOASC    .proc
        BNE  HNONZERO ;GOTO HNONZERO IF HEX digit <> 0
        CPY  #$00     ; ELSE, GOTO HTADONE IF no non-zero digits have been processed
        BEQ  HTADONE  ;  (supress output of leading zeros)
HNONZERO:
        INY           ; ELSE, indicate that a non-zero digit has been processed (Y REGISTER <> 0)
        PHA           ;Save HEX digit on STACK
        SEC
        SBC  #$0A
        BCS  HEXDIGIT ;GOTO HEXDIGIT IF digit > 9
        PLA           ; ELSE, restore digit from STACK
        ADC  #$30     ;Add ASCII "0" to digit: convert $00 through $09 to ASCII "0" through "9"
        BCC  SENDIGIT ;GOTO SENDIGIT: always branch
HEXDIGIT:
        CLC
        PLA           ;Restore digit from STACK
        ADC  #$37     ;Add ASCII "7" to digit: convert $0A through $0F to ASCII "A" through "F"
SENDIGIT:
        JSR  COUT     ;Send converted digit to terminal
HTADONE:
        RTS           ;Done HEXTOASC subroutine, RETURN
        .pend

;
;
;INCINDEX subroutine: increment 16 bit system variable INDEX,INDEXH
INCINDEX    .proc
        INC  INDEX
        BNE  INCDONE
        INC  INDEXH
INCDONE:
        RTS           ;Done INCINDEX subroutine, RETURN
        .pend

;
;MEMDMP subroutine: Send a formatted ASCII or HEX memory dump to terminal
MEMDMP  .proc
        STA  TEMP3    ;Store dump command type: 0 = HEX dump, non-0 = ASCII dump
        JSR  DMPGR    ;Send address offsets to terminal
        JSR  CROUT    ;Send CR,LF to terminal
        JSR  GLINE    ;Send horizontal line to terminal
        JSR  CROUT    ;Send CR,LF to terminal
        LDA  SCNT     ;GOTO NEWADR IF an address was entered: SCNT <> 0
        BNE  NEWADR
        LDA  TEMP2    ; ELSE, point to next consecutive memory page
        STA  INDEX    ;  address saved during last memory dump
        LDA  TEMP2H
        STA  INDEXH
        JMP  DLINE
NEWADR  JSR  JUST4.IN4      ;Convert keystrokes in INBUFF thru INBUFF + 3 to binary, result in INDEX,INDEXH
DLINE   JSR  SPC4     ;Send 4 [SPACE] to terminal
        JSR  DOLLAR   ;Send "$" to terminal
        JSR  PRINDX   ;Send line base address to terminal
        JSR  SPC4     ;Send 4 [SPACE] to terminal
        LDY  #$00     ;Initialize line byte counter
        STY  IDY
GETBYT  LDA  (INDEX),Y ;Read indexed byte
        LDX  TEMP3    ;GOTO DUMPH IF TEMP3 = 0: HEX value output was requested
        BEQ  DUMPH
        JSR  PRASC    ; ELSE, Display byte as a printable ASCII character, send "." IF not printable
        JSR  SPC      ;Send [SPACE] to terminal
        JMP  DUMPA    ;GOTO DUMPA
DUMPH   JSR  PRBYTE   ;Display byte as a HEX value
DUMPA   JSR  SPC2     ;Send 2 [SPACE] to terminal
        INC  IDY      ;Increment line byte counter
        LDY  IDY
        CPY  #$10
        BNE  GETBYT   ;LOOP back to GETBYT IF < $10 bytes have been displayed
        JSR  CROUT    ; ELSE, send CR,LF to terminal
        CLC           ;Add $10 to line base address, save result in
        LDA  INDEX    ; INDEX,INDEXH and TEMP2,TEMP2H
        ADC  #$10
        STA  INDEX
        STA  TEMP2
        BCC  ENDUMP   ;GOTO ENDUMP IF low byte ADD did not produce a CARRY
        INC  INDEXH   ; ELSE, increment high byte
        LDA  INDEXH
        STA  TEMP2H
ENDUMP  INC  IDX      ;Increment line counter
        LDX  IDX
        CPX  #$10     ;LOOP back to DLINE IF < $10 lines have been displayed
        BNE  DLINE
XITDMP  JSR  GLINE    ; ELSE, Send horizontal line to terminal
        .pend

;DMPGR subroutine: Send address offsets to terminal
DMPGR   .proc
        JSR  CROUT
        JSR  SPC4     ;Send 4 [SPACE] to terminal
        JSR  MONPROHILO
        LDA  #$0D     ;Send "adrs+" to terminal
        JSR  PROMPT
        JSR  SPC4     ;Send 4 [SPACE] to terminal
        LDX  #$00     ;Initialize line counter
        STX  IDX
MDLOOP  TXA           ;Send "00" thru "0F", separated by 2 [SPACE], to terminal
        JSR  PRBYTE
        JSR  SPC2
        INX
        CPX  #$10
        BNE  MDLOOP
        RTS           ;Done DMPGR or MEMDMP subroutine, RETURN
        .pend

;
;GLINE subroutine: Send a horizontal line to terminal
GLINE   .proc
        LDX  #$4F
        LDA  #'~'     ;Send "~" to terminal 79 times
GLINEL  JSR  COUT
        DEX
        BNE  GLINEL
        RTS           ;Done GLINE subroutine, RETURN
        .pend

;
;
;
;PRASC subroutine: Send byte in ACCUMULATOR to terminal IF it is a printable ASCII character,
; ELSE, send "." to terminal. Printable ASCII byte values = $20 through $7E
;PERIOD subroutine: Send "." to terminal
PRASC   .proc
        CMP  #$7F
        BCS  PERIOD   ;GOTO PERIOD IF byte >= $7F
        CMP  #$20
        BCS  ASCOUT   ; ELSE, GOTO ASCOUT IF byte >= $20
PERIOD:
        LDA  #$2E     ;  ELSE, load ACCUMULATOR with "."
ASCOUT:
        JMP  COUT     ;Send byte in ACCUMULATOR to terminal then done PRASC subroutine, RETURN
        .pend

;
;PRBYTE subroutine: Send 2 ASCII HEX digits to terminal which represent value in ACCUMULATOR
PRBYTE  .proc
        JSR  SAVREGS  ;Save ACCUMULATOR, X,Y REGISTERS on STACK
        JSR  BN2ASC   ;Convert byte in ACCUMULATOR to 2 ASCII HEX digits
        JSR  COUT     ;Send most significant HEX digit to terminal
        TYA
        JSR  COUT     ;Send least significant HEX digit to terminal
        JSR  RESREGS  ;Restore ACCUMULATOR, X,Y REGISTERS from STACK
        RTS           ;Done PRBYTE subroutine, RETURN
        .pend

;
;PRINDX subroutine: Send 4 ASCII HEX digits to terminal which represent value in
; 16 bit variable INDEX,INDEXH
PRINDX  .proc
        PHA           ;Save ACCUMULATOR
        LDA  INDEXH   ;Display INDEX high byte
        JSR  PRBYTE
        LDA  INDEX    ;Display INDEX low byte
        JSR  PRBYTE
        PLA           ;Restore ACCUMULATOR
        RTS           ;Done PRINDX subroutine, RETURN
        .pend

;
;PROMPT subroutine: Send indexed text string to terminal. Index is ACCUMULATOR,
; strings buffer address is stored in variable PROLO, PROHI.
; PROMPT subroutine.

PROMPT  .proc
        JSR  SAVREGS    ;Save ACCUMULATOR, X,Y REGISTERS on STACK
        TAX             ;Initialize string counter from ACCUMULATOR
        LDY  #0         ;Initialize byte counter
FIND:
        LDA  (PROLO),Y  ;Read indexed byte from buffer
        BEQ  ZERO       ;GOTO ZERO IF byte = $00
NEXT:
        INY             ; ELSE, increment byte counter
        BNE  FIND       ;GOTO FIND IF counter != 0
        INC  PROHI      ; ELSE, increment page
        BRA  FIND       ;GOTO FIND
ZERO:
        DEX             ;Decrement string counter
        BNE  NEXT       ;LOOP back to NEXT IF string counter <> 0
        INY
;Send indexed string to terminal
STRINGL:
        LDA  (PROLO),Y  ;Read indexed byte from buffer
        BEQ  QUITP      ;GOTO QUITP IF byte = $00
        JSR  COUT       ; ELSE, send byte to terminal
        INY             ;Increment byte counter
        BNE  STRINGL    ;LOOP back to STRINGL: always branch
        INC  PROHI      ;Message > 255 chars, so increment page
        BRA  STRINGL    ;LOOP back to STRINGL
QUITP:
        JSR  RESREGS    ;Restore ACCUMULATOR, X,Y REGISTERS from STACK
        RTS             ;Done PROMPT subroutine, RETURN
        .pend


;
;READ subroutine: Read from address pointed to by INDEX,INDEXH
READ    .proc
        LDY  #$00
        LDA  (INDEX),Y
        RTS           ;Done READ subroutine, RETURN
        .pend

;
;RDCHAR subroutine: Wait for a keystroke then clear bit 7 of keystroke value.
; IF keystroke is a lower-case alphabetical, convert it to upper-case
RDCHAR  .proc
        JSR  CHIN     ;Request keystroke input from terminal
        AND  #$7F     ;Clear bit 7 of keystroke value
        CMP  #$61
        BCC  AOK      ;GOTO AOK IF keystroke value < $61: a control code, upper-case alpha or numeral
        SEC           ; ELSE, subtract $20: convert to upper-case
        SBC  #$20
AOK
        RTS           ;Done RDCHAR subroutine, RETURN
        .pend

;
;The following subroutine (RDLINE) is derivative of published material:
; (pp. 418-424)
; "6502 assembly language subroutines"
; By Lance A. Leventhal, Winthrope Saville
; copyright 1982 by McGraw-Hill
; ISBN: 0-931988-59-4
;RDLINE subroutine: Setup a keystroke input buffer then store keystrokes in buffer
; until [RETURN] key it struck. Lower-case alphabeticals are converted to upper-case.
;Call with:
; ACCUMULATOR = buffer address high byte
; Y REGISTER  = buffer address low byte
; X REGISTER  = buffer length
;IF variable LOKOUT = $00 then allow all keystrokes.
;IF variable LOKOUT = $FF then allow only ASCII DECIMAL numeral input: 0123456789
;IF variable LOKOUT = $01 through $FE then allow only valid ASCII HEX numeral input: 0123456789ABCDEF
;[BACKSPACE] key removes keystrokes from buffer.
;[ESCAPE] key aborts RDLINE then re-enters monitor.
RDLINE  .proc
        STA  BUFADRH  ;Store buffer address high byte
        STY  BUFADR   ;Store buffer address low byte
        STX  BUFLEN   ;Store buffer length
        STZ  BUFIDX   ;Initialize RDLINE buffer index: # of keystrokes stored in buffer = 0
RDLOOP
        JSR  RDCHAR   ;Request keystroke input from terminal, convert lower-case Alpha. to upper-case
        CMP  #$1B     ;GOTO NOTESC IF keystroke <> [ESCAPE]
        BNE  NOTESC
        JMP  MONITOR.NMON     ; ELSE, abort RDLINE, GOTO NMON: re-enter monitor
;****Replace above JMP NMON with NOP, NOP, NOP to DISABLE********************************************************
; [ESCAPE] key function during RDLINE keystroke input,
; including HEXIN subroutine digit input
; This will prevent application users from inadvertently
; entering SyMon monitor****
NOTESC
        CMP  #$0D     ;GOTO EXITRD IF keystroke = [RETURN]
        BEQ  EXITRD
        CMP  #$08     ; ELSE, GOTO BACK IF keystroke = [BACKSPACE]
        BEQ  BACK
        LDX  LOKOUT   ; ELSE, GOTO FULTST IF variable LOKOUT = $00: keystroke filter is disabled
        BEQ  FULTST
        CMP  #$30     ; ELSE, filter enabled, GOTO INERR IF keystroke value < $30: value < ASCII "0"
        BCC  INERR
        CMP  #$47     ; ELSE, GOTO INERR IF keystroke >= $47: value >= ASCII "G" ("F" + 1)
        BCS  INERR
        CMP  #$41     ; ELSE, GOTO DECONLY IF keystroke >= $41: value >= ASCII "A"
        BCS  DECONLY
        BCC  DECTEST  ; ELSE, GOTO DECTEST: keystroke < $41: value < ASCII "A"
DECONLY:
        CPX  #$FF     ;GOTO FULTST IF LOKOUT variable != $FF: ASCII DECIMAL digit filter disabled
        BNE  FULTST
DECTEST:
        CMP  #$3A     ; ELSE, DECIMAL filter enabled, GOTO INERR IF keystroke = OR > $3A:
        BCS  INERR    ;   value >= ASCII ":" ("9" + 1)
FULTST:
        LDY  BUFIDX   ; ELSE, GOTO STRCH IF BUFIDX != BUFLEN: buffer is not full
        CPY  BUFLEN
        BCC  STRCH
INERR
        JSR  BEEP     ; ELSE, Send [BELL] to terminal
        BRA  RDLOOP   ;LOOP back to RDLOOP: always branch
STRCH:
        STA  (BUFADR),Y ;Store keystroke in buffer
        JSR  COUT     ;Send keystroke to terminal
        INC  BUFIDX   ;Increment buffer index
        BRA  RDLOOP   ;LOOP back to RDLOOP: always branch
EXITRD:
        LDX  BUFIDX   ;Copy keystroke count to X-REGISTER
        RTS           ;Done RDLINE subroutine, RETURN
        .pend

;Perform a destructive [BACKSPACE]
BACK    .proc
        LDA  BUFIDX   ;GOTO BSERROR IF buffer is empty
        BEQ  BSERROR
        DEC  BUFIDX   ; ELSE, decrement buffer index
        JSR  BSOUT    ;Send [BACKSPACE] to terminal
        JSR  SPC      ;Send [SPACE] to terminal
        JSR  BSOUT    ;Send [BACKSPACE] to terminal
        BRA  RDLINE.RDLOOP   ;LOOP back to RDLOOP: always branch
BSERROR:
        JSR  BEEP     ;Send [BELL] to terminal
        BRA  RDLINE.RDLOOP   ;LOOP back to RDLOOP: always branch
        .pend

;
;SAVREGS subroutine: save a copy of ACCUMULATOR, X,Y REGISTERS on the STACK.
;This is used in conjunction with the RESREGS subroutine
SAVREGS .proc
        STA  SAVEACC
        STX  SAVEX
        STY  SAVEY
        RTS
        .pend

;
;RESREGS subroutine: restore ACCUMULATOR, X,Y REGISTERS from the copy previously saved
; on the STACK by the SAVREGS subroutine
RESREGS .proc
        LDA SAVEACC
        LDX SAVEX
        LDY SAVEY
        RTS
        .pend

;
;SBYTSTR subroutine: request 0 - 16 byte string from terminal, each byte followed by [RETURN].
; [ESCAPE] aborts. String will be stored in 16 byte buffer beginning at address SRCHBUFF.
; Y REGISTER holds number of bytes in buffer. This is used by monitor text/byte string
; search commands
SBYTSTR                           .proc
        LDY  #$00     ;Initialize index/byte counter
SBLOOP:
        STY  IDY      ;Save index/byte counter
        LDA  #$02     ;Request 2 HEX digit input from terminal (byte value)
        JSR  HEXIN
        JSR  SPC2     ;Send 2 [SPACE] to terminal
        LDY  IDY      ;Restore index/byte counter
        CPX  #$00     ;GOTO DONESB IF no digits were entered
        BEQ  DONESB
        STA  SRCHBUFF,Y ; ELSE, Store byte in indexed buffer location
        INY           ;Increment index/byte counter
        CPY  #$10     ;LOOP back to SBLOOP IF index/byte counter < $10
        BNE  SBLOOP
DONESB:
        RTS           ; ELSE, done SBYTSTR, RETURN
                                  .pend

;
;SENGINE subroutine: Scan memory range $0400 through $FFFF for exact match to string
; contained in buffer SRCHBUFF (1 to 16 bytes/characters). Display address of first
; byte/character of each match found until the end of memory is reached.
; This is used by monitor text/byte string search commands
SENGINE .proc
        CPY  #$00     ;GOTO DUNSENG IF SRCHBUFF buffer is empty
        BEQ  DUNSENG
        STY  IDY      ; ELSE, save buffer byte/character count
        LDA  #$04     ;Initialize memory address pointer to $0400: skip over $0000 through $0300
        STA  INDEXH
        LDY  #$00     ; and initialize (zero) memory address index
        STY  INDEX
SENGBR2:
        LDX  #$00     ;Initialize buffer index: point to first byte/character in buffer
SENGBR3:
        LDA  (INDEX),Y ;Read current memory location
        CMP  SRCHBUFF,X ;GOTO SENGBR1 IF memory matches indexed byte/character in buffer
        BEQ  SENGBR1
        LDX  #$00     ; ELSE, initialize buffer index: point to first byte/character in string
        LDA  (INDEX),Y ;Read current memory location
        CMP  SRCHBUFF,X ;GOTO SENGBR2 IF memory matches indexed byte/character in buffer
        BEQ  SENGBR2
        JSR  SINCPTR  ; ELSE, increment memory address pointer, test for end of memory
        BRA  SENGBR2  ;LOOP back to SENGBR2
SENGBR1:
        JSR  SINCPTR  ;Increment memory address pointer, test for end of memory
        INX           ;Increment buffer index
        CPX  IDY      ;LOOP back to SENGBR3 IF buffer index <> memory index
        BNE  SENGBR3
        SEC           ; ELSE, subtract buffer index from memory address pointer:
        LDA  INDEX    ;  (point to first byte of matching string found in memory)
        SBC  IDY
        STA  INDEX
        LDA  INDEXH
        SBC  #$00
        STA  INDEXH
        LDA  #$0A     ;Send "found " to terminal
        JSR  PROMPT
        LDA  #$0C     ;Send "at: $" to terminal
        JSR  PROMPT
        LDA  INDEXH   ;Display address of matching string
        JSR  PRBYTE
        LDA  INDEX
        JSR  PRBYTE
        LDA  #$0E     ;Send "N=Next? " to terminal
        JSR  PROMPT
        JSR  CHIN     ;Request a keystroke from terminal
        AND  #$DF     ;Convert lower case Alpha. to upper case
        CMP  #$4E     ;GOTO DUNSENG IF keystroke <> "N"
        BNE  DUNSENG
        JSR  SINCPTR  ;ELSE, increment memory address pointer, test for end of memory
        BRA  SENGBR2  ;LOOP back to SENGBR2
DUNSENG:
        LDA  INCNT    ;Remove last keystroke from keystroke input buffer
        STA  OUTCNT
        RTS           ;Done SENGINE subroutine, RETURN
;Increment memory address pointer. If pointer high byte = 00 (end of memory),
; send "not found" to terminal then return to monitor
SINCPTR:
        JSR  INCINDEX ;Increment memory address pointer
        CMP  #$00     ;GOTO DUNSINC IF memory address pointer high byte <> 00
        BNE  DUNSINC
        LDA  #$0B     ; ELSE, send "not " to terminal
        JSR  PROMPT
        LDA  #$0A     ;Send "found " to terminal
        JSR  PROMPT
        LDA  INCNT    ;Remove last keystroke from keystroke input buffer
        STA  OUTCNT
        JMP  NMON     ;Done SRCHBYT or SRCHTXT command, GOTO NMON: return to monitor
DUNSINC:
        RTS           ;Done SINCPTR subroutine, RETURN
        .pend

;
;SET subroutine: Set TIMER duration from X REGISTER then call TIMER.
;TIMER subroutine: Perform a long delay. Duration is SETIM * (DELLO * DELHI)
SET     .proc
        STX  SETIM    ;Store duration value in SETIM variable
TIMER:
        JSR  SAVREGS  ;Save ACCUMULATOR, X,Y REGISTERS on STACK
        LDX  SETIM    ;Copy SETIM to TEMP variable: TIMER multiplier
        STX  TEMP
TIMERL:
        JSR  DELAY1.DELAY2   ;Perform a medium delay. Duration is DELLO * DELHI
        DEC  TEMP     ;Decrement TIMER multiplier
        BNE  TIMERL   ;LOOP back to TIMERL IF TIMER multiplier <> 0
        JSR  RESREGS  ; ELSE, restore ACCUMULATOR, X,Y REGISTERS from STACK
        RTS           ;Done SET or TIMER subroutine, RETURN
        .pend

;
;SETUP subroutine: Request HEX address input from terminal
SETUP   .proc
        JSR  COUT     ;Send command keystroke to terminal
        JSR  SPC      ;Send [SPACE] to terminal
;Request a 0-4 digit HEX address input from terminal
        JSR  HEXIN4   ; result in variable INDEX,INDEXH
        LDA  #$3A     ;Send ":" to terminal
        JSR  COUT
        JMP  DOLLAR   ;Send "$" to terminal then done SETUP subroutine, RETURN
        .pend

;
;SPC subroutines: Send [SPACE] to terminal 1,2 or 4 times
SPC4    .proc
        JSR  SPC2     ;Send 4 [SPACE] to terminal
        .pend

SPC2    .proc
        JSR  SPC      ;Send 2 [SPACE] to terminal
        .pend


SPC     .proc
        PHA           ;Save ACCUMULATOR
        LDA  #$20     ;Send [SPACE] to terminal
        JSR  COUT
        PLA           ;Restore ACCUMULATOR
        RTS           ;Done SPC(n) subroutine, RETURN
        .pend

;
;GET_UP_TO_16_CHR_STRING subroutine: request 1 - 16 character text string from terminal, followed by [RETURN].
; [ESCAPE] aborts, [BACKSPACE] erases last keystroke. String will be stored in
; 16 byte buffer beginning at address SRCHBUFF. Y REGISTER holds number of characters in buffer
; This is used by monitor text/byte string search commands
GET_UP_TO_16_CHR_STRING           .proc
        LDY  #$00     ;Initialize index/byte counter
STLOOP:
        JSR  CHIN     ;Request keystroke input from terminal
        CMP  #$0D     ;GOTO STBR1 IF keystroke = [RETURN]
        BEQ  STBR1
        CMP  #$1B     ; ELSE, GOTO STBR2 IF keystroke <> [ESCAPE]
        BNE  STBR2
        LDY  #$00     ; ELSE, indicate that there are no keystrokes to process
STBR1:
        RTS           ;Done GET_UP_TO_16_CHR_STRING subroutine, RETURN
STBR2:
        CMP  #$08     ;GOTO STBR3 IF keystroke <> [BACKSPACE]
        BNE  STBR3
        TYA           ; ELSE, LOOP back to STLOOP IF buffer is empty
        BEQ  STLOOP
        JSR  BSOUT    ; ELSE, send [BACKSPACE] to terminal
        DEY           ;Decrement index/byte counter
        BRA  STLOOP   ;LOOP back to STLOOP
STBR3:
        STA  SRCHBUFF,Y ;Store character in indexed buffer location
        JSR  COUT     ;Send character to terminal
        INY           ;Increment index/byte counter
        CPY  #$10     ;LOOP back to STLOOP IF index/byte counter < $10
        BNE  STLOOP
        RTS           ; ELSE, done GET_UP_TO_16_CHR_STRING subroutine, RETURN
        .pend

;
;
;******************************
;* Monitor command processors *
;******************************
;
;[invalid] command: No command assigned to keystroke. This handles unassigned keystrokes
ERR     .proc
        JSR  BEEP     ;Send ASCII [BELL] to terminal
        PLA           ;Remove normal return address because we don't
        PLA           ; want to send a monitor prompt in this case
        JMP  MONITOR.CMON     ;GOTO CMON re-enter monitor
        .pend

;[D] Hex and ASCII dump command. Display in HEX and printable ASCII memory address until [ENTER] is pressed.
;Pause after 256 bytes.
;
MDUMP   .proc
        JSR  SETUP
        LDA  #0
        JMP  MEMDMP
        .pend
;
;
;[F] MFILL command: Fill a specified memory range with a specified value
MFILL   .proc
        JSR  ASMPROHILO ;Point to prompt strings array
        LDA  #$02     ;Send CR,LF, "fill start: " to terminal
        JSR  PROMPT
        JSR  HEXIN4   ;Request 4 digit HEX value input from terminal. Result in variable INDEX,INDEXH
        LDX  SCNT     ;GOTO DUNFILL IF no digits were entered
        BEQ  DONEFILL
        LDA  INDEX    ; ELSE, copy INDEX,INDEXH to TEMP2,TEMP2H: memory fill start address
        STA  TEMP2
        LDA  INDEXH
        STA  TEMP2H
        LDA  #$03     ;Send CR,LF, "length: " to terminal
        JSR  PROMPT
        JSR  HEXIN4   ;Request 4 digit HEX value input from terminal. Result in variable INDEX,INDEXH: memory fill length
        LDX  SCNT     ;GOTO DUNFILL IF no digits were entered
        BEQ  DONEFILL
        LDA  #$04     ; ELSE, send CR,LF, "value: " to terminal
        JSR  PROMPT
        JSR  HEXIN2   ;Request 2 digit HEX value input from terminal. Result in ACCUMULATOR: fill value
        LDX  SCNT     ;GOTO DUNFILL IF no digits were entered
        BEQ  DONEFILL
        PHA           ;Save fill value on STACK
        LDA  #$01     ;Send CR,LF, "Esc key exits, any other to proceed" to terminal
        JSR  PROMPT
        JSR  CHIN     ;Request keystroke input from terminal
        CMP  #$1B     ;GOTO QUITFILL IF keystroke = [ESCAPE]
        BEQ  QUITFILL
        PLA           ; ELSE, pull fill value from STACK
USERFILL:
        LDX  INDEXH   ;Copy INDEXH to X REGISTER: X = length parameter page counter
        BEQ  FILEFT   ;GOTO FILEFT IF page counter = $00
        LDY  #$00     ; ELSE, initialize page byte address index
PGFILL:
        STA  (TEMP2),Y ;Store fill value at indexed current page address
        INY           ;Increment page byte address index
        BNE  PGFILL   ;LOOP back to PGFILL IF page byte address index <> $00
        INC  TEMP2H   ; ELSE, Increment page address high byte
        DEX           ;Decrement page counter
        BNE  PGFILL   ;LOOP back to PGFILL IF page counter <> $00
FILEFT:
        LDX  INDEX    ; ELSE, copy INDEX to X REGISTER: X = length parameter byte counter
        BEQ  DONEFILL ;GOTO DONEFILL IF byte counter = $00
        LDY  #$00     ; ELSE, initialize page byte address index
FILAST:
        STA  (TEMP2),Y ;Store fill value at indexed current page address
        INY           ;Increment page byte address index
        DEX           ;Decrement byte counter
        BNE  FILAST   ;LOOP back to FILAST IF byte counter <> $00
QUITFILL:
        PLA           ;Pull saved fill value from STACK: value not needed, discard
DONEFILL:
        RTS           ;Done MFILL command, RETURN
        .pend
;
;[G] GO command: Begin executing program code at a specified address
GO      .proc
        JSR  SETUP    ;Request HEX address input from terminal
        JSR  CROUT    ;Send CR,LF to terminal
        LDA  INDEX    ;Transfer specified address to monitor command processor
        STA  COMLO    ; address pointer low byte
        LDA  INDEXH
        STA  COMHI    ;  hi byte
CTRLUGO
        TSX           ;Save the monitor's STACK POINTER in memory
        STX  POINTER
;Preload all 6502 MPU registers from monitor's preset/result variables
        LDX  SREG     ;Load STACK POINTER preset
        TXS
        LDA  PREG     ;Load PROCESSOR STATUS REGISTER preset
        PHA
        LDA  ACCUM    ;Load ACCUMULATOR preset
        LDX  XREG     ;Load X-REGISTER preset
        LDY  YREG     ;Load Y-REGISTER preset
        PLP
;Call user program code as a subroutine
        JSR  DOCOM
;Store all 6502 MPU registers to monitor's preset/result variables: store results
        PHP
        STA  ACCUM    ;Store ACCUMULATOR result
        STX  XREG     ;Store X-REGISTER result
        STY  YREG     ;Store Y-REGISTER result
        PLA
        STA  PREG     ;Store PROCESSOR STATUS REGISTER result
        TSX
        STX  SREG     ;Store STACK POINTER result
        LDX  POINTER  ;Restore the monitor's STACK POINTER
        TXS
        CLD           ;Put 6502 in binary arithmatic mode
        RTS           ;Done GO command, RETURN
        .pend
;
;The following command processor (MOVER) is derivative of published material:
; (pp. 197-203)
; "6502 assembly language subroutines"
; By Lance A. Leventhal, Winthrope Saville
; copyright 1982 by McGraw-Hill
; ISBN: 0-931988-59-4
;[M] MOVER command: Move (copy) specified source memory area to specified destination memory area
MOVER   .proc
        JSR  ASMPROHILO ;Point to prompt strings array
        LDA  #$05     ;Send CR,LF, "move source: " to terminal
        JSR  PROMPT
        JSR  HEXIN4   ;Request 4 digit HEX value input from terminal. Result in variable INDEX,INDEXH: memory move source address
        LDX  SCNT     ;GOTO QUITMV IF no digits were entered
        BEQ  QUITMV
        STA  TEMP3    ; ELSE, store source address in variable TEMP3,TEMP3H
        LDA  INDEXH
        STA  TEMP3H
        LDA  #$06     ;Send CR,LF, "destination: " to terminal
        JSR  PROMPT
        JSR  HEXIN4   ;Request 4 digit HEX value input from terminal. Result in variable INDEX,INDEXH: memory move destination address
        LDX  SCNT     ;GOTO QUITMV IF no digits were entered
        BEQ  QUITMV
        STA  TEMP2    ; ELSE, store destination address in variable TEMP2,TEMP2H
        LDA  INDEXH
        STA  TEMP2H
        LDA  #$03     ;Send CR,LF, "length: " to terminal
        JSR  PROMPT
        JSR  HEXIN4   ;Request 4 digit HEX value input from terminal. Result in variable INDEX,INDEXH: memory move length
        LDX  SCNT     ;GOTO QUITMV IF no digits were entered
        BEQ  QUITMV
        LDA  #$01     ;Send CR,LF, "Esc key exits, any other to proceed" to terminal
        JSR  PROMPT
        JSR  CHIN     ;Request keystroke input from terminal
        CMP  #$1B     ;GOTO QUITMV IF keystroke = [ESCAPE]
        BEQ  QUITMV
        LDA  TEMP2    ; ELSE, GOTO RIGHT IF source memory area is above destination memory area
        SEC           ;  AND overlaps it (destination address - source address) < length of move
        SBC  TEMP3
        TAX           ;   X REGISTER = destination address low byte - source address low byte
        LDA  TEMP2H
        SBC  TEMP3H
        TAY           ;   Y REGISTER = destination address high byte - (source address high byte + borrow)
        TXA
        CMP  INDEX    ;   produce borrow IF (destination address low - source address low) < destination low
        TYA
        SBC  INDEXH   ;   produce borrow IF ((destination address high - source address high) + borrow) < dest. high
        BCC  RIGHT    ;   Branch if a borrow was produced (unmoved source memory overwrite condition detected)
;Move memory block first byte to last byte
        LDY  #$00     ; ELSE, initialize page byte index
        LDX  INDEXH   ;Copy length high byte to X REGISTER: page counter
        BEQ  MVREST   ;GOTO MVREST IF move length is < $100 bytes
MVPGE:
        LDA  (TEMP3),Y ; ELSE, move (copy) byte from indexed source to indexed destination memory
        STA  (TEMP2),Y
        INY           ;Increment page byte index
        BNE  MVPGE    ;LOOP back to MVPAGE IF page byte index <> 0: loop until entire page is moved
        INC  TEMP3H   ; ELSE, increment source page address
        INC  TEMP2H   ;Increment destination page address
        DEX           ;Decrement page counter
        BNE  MVPGE    ;LOOP back to MVPAGE IF page counter <> 0: there are more full pages to move
                      ; ELSE,(page byte index (Y REGISTER) = 0 at this point)
MVREST:
        LDX  INDEX    ;Copy length parameter low byte to X REGISTER: byte counter
        BEQ  QUITMV   ;GOTO QUITMV IF byte counter = 0: there are no bytes left to move
REST:
        LDA  (TEMP3),Y ; ELSE, move (copy) byte from indexed source to indexed destination memory
        STA  (TEMP2),Y
        INY           ;Increment page byte index
        DEX           ;Decrement byte counter
        BNE  REST     ;LOOP back to REST IF byte counter <> 0: loop until all remaining bytes are moved
QUITMV:
        RTS           ; ELSE, done MOVER command, RETURN

;Move memory block last byte to first byte (avoids unmoved source memory overwrite in certain source/dest. overlap)
RIGHT
        LDA  INDEXH   ;Point to highest address page in source memory block
        CLC           ;  source high byte = (source high byte + length high byte)
        ADC  TEMP3H
        STA  TEMP3H
        LDA  INDEXH   ;Point to highest address page in destination memory block
        CLC           ;  destination high byte = (destination high byte + length high byte)
        ADC  TEMP2H
        STA  TEMP2H
        LDY  INDEX    ;Copy length low byte to Y REGISTER: page byte index
        BEQ  MVPAG    ;GOTO MVPAG IF page byte index = 0: no partial page to move
RT:
        DEY           ; ELSE, decrement page byte index
        LDA  (TEMP3),Y ;Move (copy) byte from indexed source to indexed destination memory
        STA  (TEMP2),Y
        CPY  #$00     ;LOOP back to RT IF page byte index <> 0: loop until partial page is moved
        BNE  RT
MVPAG:
        LDX  INDEXH   ; ELSE, copy length high byte to X REGISTER: page counter
        BEQ  QUITMV   ;GOTO QUITMV IF page counter = 0: no full pages left to move
RDEC:
        DEC  TEMP3H   ; ELSE, decrement source page address
        DEC  TEMP2H   ;Decrement destination page address
RMOV:
        DEY           ;Decrement page byte index
        LDA  (TEMP3),Y ;Move (copy) byte from indexed source to indexed destination memory
        STA  (TEMP2),Y
        CPY  #$00     ;LOOP back to RMOV IF page byte index <> 0: loop until entire page is moved
        BNE  RMOV
        DEX           ; ELSE, decrement page counter
        BNE  RDEC     ;LOOP back to RDEC IF page counter <> 0: loop until all full pages are moved
        RTS           ; ELSE, done MOVER command, RETURN
        .pend

;
;
;
;PRBIT subroutine: Send "0" or "1" to terminal depending on condition of indexed bit in
; PROCESSOR STATUS preset/result
PRBIT   .proc
        LDA  #':'     ;Send ":" to terminal
        JSR  COUT
        LDA  PREG     ;Read PROCESSOR STATUS preset/result
;Select number of shifts required to isolate indexed bit
        CPX  #$0B
        BEQ  LS1
        CPX  #$0E
        BEQ  LS2
        CPX  #$11
        BEQ  LS4
        CPX  #$14
        BEQ  LS5
        CPX  #$17
        BEQ  LS6
        CPX  #$1A
        BEQ  LS7
;Left-shift indexed bit into CARRY flag
        ASL        ;Bit 0 CARRY
LS7:
        ASL        ;Bit 1 ZERO
LS6:
        ASL        ;Bit 2 INTERRUPT REQUEST
LS5:
        ASL        ;Bit 3 DECIMAL
LS4:
        ASL        ;Bit 4 BREAK
        ASL        ;Bit 5 (This bit is undefined in the 6502 PROCESSOR STATUS REGISTER)
LS2:
        ASL        ;Bit 6 OVERFLOW
LS1:
        ASL        ;Bit 7 NEGATIVE
        BCS  BITSET   ;Send "0" to terminal IF bit is clear
        LDA  #$30
        BNE  RDONE
BITSET:
        LDA  #$31     ; ELSE, Send "1" to terminal
RDONE:
        JSR  COUT
        JMP  SPC      ;Send [SPACE] to terminal then done PRBIT subroutine, RETURN
        .pend

REGARA:
        .text  "AXYSP"
        .text  "-> NEGOVRBRK"
        .text  "DECIRQZERCAR "
;
;[S] STACK POINTER command: Display then change STACK POINTER preset/result
SRG     .proc
        LDA  #$10     ;Send "stack pointer:$" to terminal
        JSR  PROMPT
        LDA  SREG     ;Read STACK POINTER preset/result
        JSR  CHREG    ;Display preset/result, request HEX byte input from terminal
        LDX  SCNT     ;GOTO NCSREG IF no digits were entered
        BEQ  NCSREG
        STA  SREG     ; ELSE, write entered byte to STACK POINTER preset/result
NCSREG:
        RTS           ;Done SRG command, RETURN
        .pend

;
;

PROMPT2 .proc
        LDY  #$00     ;Read from current view memory address
        LDA  (INDEX),Y
        BEQ  VIEWEXIT ;GOTO VIEWEXIT IF byte read = 0
        JSR  COUT     ; ELSE, send character/byte read to terminal
        JSR  INCINDEX ;Increment view memory address pointer
        BRA  PROMPT2  ;LOOP back to PROMPT2
VIEWEXIT:
        RTS           ;Done VIEWTXT command, RETURN
        .pend

;
;[W] WATCH command: Continuously read then display contents of a specified address, loop until keystroke
WATCH   .proc
        JSR  SETUP    ;Request HEX address input from terminal
WATCHL
        JSR  READ     ;Read specified address
        JSR  PRBYTE   ;Display HEX value read
        JSR  DELAY1.DELAY2   ;Do a medium (~ 0.2 second) delay
        LDA  #$08     ;Send 2 [BACKSPACE] to terminal
        JSR  COUT2
        CLI           ;Enable IRQ service
        LDA  INCNT    ;LOOP back to WATCHL IF INCNT = OUTCNT: no key was struck
        CMP  OUTCNT
        BEQ  WATCHL
        SEI           ; ELSE, Disable IRQ service
        INC  OUTCNT   ;Remove last keystroke from buffer
        RTS           ;Done WATCH command, RETURN
        .pend

;
;[CTRL-D] DOWNLOAD command: Receive a formatted ASCII HEX file from terminal,
; convert file from ASCII HEX to binary, store binary values in memory.
; The first character in the file MUST be a dollar sign ($), followed by FOUR
; ASCII HEX digits. These 4 digits represent the address at which to begin
; storing the downloaded/converted file data. What follows is the ASCII HEX
; representations of the binary file data, each byte being represented by TWO
; ASCII HEX digits (leading zeros MUST be included). IF a dollar sign ($) is
; again received, a new FOUR digit ASCII HEX address is expected, followed by
; more ASCII HEX file data.
; The last character in the file MUST be an asterisk (*). This indicates
; the end of the file and terminates the DOWNLOAD command.
; The ONLY printable ASCII characters allowed are: $*0123456789ABCDEF
; (note only upper-case ABCDEF)
; The ONLY ASCII control codes allowed are: [SPACE][RETURN][LINEFEED]
; All other ASCII input may cause errors.
; The monitor [U] UPLOAD command produces formatted ASCII HEX file output to terminal
DOWNLOAD   .proc
         LDA  #$09     ;Send "Download:" to terminal
         JSR  PROMPT
         LDA  #$E0     ;Point to $E0xx (ROM area) in case of garbage input:
         STA  INDEXH   ; write $E0 to download destination address pointer high byte
DLOOP    JSR  CHIN     ;Request a keystroke from terminal
         CMP  #' '     ; LOOP back to DLOOP IF character = [SPACE]: ignore character
         BEQ  DLOOP
         CMP  #$0D     ; ELSE, LOOP back to DLOOP IF character = [RETURN]: ignore character
         BEQ  DLOOP
         CMP  #$0A     ; ELSE, LOOP back to DLOOP IF character = [LINEFEED]: ignore character
         BEQ  DLOOP
         CMP  #'*'     ; ELSE, GOTO DBR1 IF chatacter <> "*": End Of File
         BNE  DBR1
         JMP  MONITOR.NMON     ; ELSE, done DOWNLOAD, GOTO NMON
;
DBR1     CMP  #'$'     ;GOTO DNEWADR IF character = "$"
         BEQ  DNEWADR
         JSR  DSUB1    ; ELSE, this is a high digit, go get low digit then convert ASCII HEX digits to binary
         LDY  #$00     ;Store byte at address pointed to by destination address pointer
         STA  (INDEX),Y
         JSR  INCINDEX ;Increment destination address pointer
         JMP  DLOOP    ;LOOP back to DLOOP
;
DNEWADR  JSR  DSUB2    ;Request 2 ASCII HEX digits from terminal then convert to binary
         STA  INDEXH   ;Write value to destination address pointer high byte
         JSR  DSUB2    ;Request 2 ASCII HEX digits from terminal then convert to binary
         STA  INDEX    ;Write value to destination address pointer low byte
         JMP  DLOOP    ;LOOP back to DLOOP
;
DSUB2    JSR  CHIN     ;Request a keystroke from terminal, result in ACCUMULATOR
DSUB1    PHA           ;Save ACCUMULATOR on STACK: ASCII HEX high digit of a byte
         JSR  CHIN     ;Request a keystroke from terminal: ASCII HEX low digit
         TAY           ;Copy low digit to Y REGISTER
         PLA           ;Pull ACCUMULATOR from STACK: high digit
         JSR  ASC2BN   ;Convert high/low ASCII HEX digits to a binary value, result in ACCUMULATOR
         RTS           ;Done DSUB1 or DSUB2 subroutine, RETURN
        .pend

;
;[CTRL-L] LISTER command: call disassembler
LISTER  .proc
        JSR  ASMPROHILO ;Point to assembler/disassembler prompt strings
        JSR  LIST     ;Call disassembler
        JSR  MONPROHILO ;Point to monitor prompt strings
RET     RTS           ;Done LISTER command, RETURN. RET label is defined for [BREAK] button
        .pend

;
;
;[CTRL-W] WIPE command: clear (write: $00) RAM memory from $0000 through $7F00 then coldstart SyMon
WIPE    .proc
        LDA  #$15     ;Send "Wipe RAM?" to terminal
        JSR  PROMPT
        JSR  ASMPROHILO ;Point INDEX to strings
        LDA  #$01     ;Send CR,LF,"ESC key exits, any other to proceed" to terminal
        JSR  PROMPT
        JSR  CHIN     ;Request a keystroke from terminal
        CMP  #$1B     ;GOTO DOWIPE IF keystroke <> [ESC]
        BNE  DOWIPE
        RTS           ; ELSE, abort WIPE command, RETURN
DOWIPE:
        LDA  #$02     ;Initialize temporary address pointer to $0002
        STA  $00
        LDA  #$00
        STA  $01
        TAX             ;Make index offset, ACCUMULATOR both = $00
WIPELOOP
        STA  ($00,X)    ;Write $00 to current address
        INC  $00        ;Increment address pointer
        BNE  WIPELOOP
        INC  $01
        LDY  $01        ; stop if we are at
        CPY  #$7F       ; $7F00 to protect the I/O area.
        BEQ  EXIT
        BRA  WIPELOOP   ;LOOP back to WIPELOOP IF address pointer < $7F00
EXIT
        STA  $01        ; ELSE, clear address pointer
        .pend

; Done WIPE command, GOTO COLDSTART
;
;
;*********************************
;* COLDSTART: Power-up OR        *
;* pushbutton RESET vectors here *
;* Also WIPE command will call   *
;* this.
;*********************************
;
COLDSTART
        SEI         ;Turn off interrupts while initialising hardware
        CLD         ;Disable decimal mode
        LDX  #$FF   ;Initialize STACK POINTER
        TXS

;;; Initialise interrupt vector
        LDA  #<DOINTERRUPT
        STA  IRQVECTOR
        LDA  #>DOINTERRUPT
        STA  IRQVECTOR+1

;;; Initialise IDE
    ; JSR IDE_INIT_DEVICES
;;; End init IDE

;;; Initialise ACIA
        JSR  INITACIA
;;; End init ACIA

;;; Initialise VIA
        JSR  INITVIA
;; End init VIA

;;; Initialise RTC
        JSR  INITRTC
;;; End init RTC

        CLI             ; Turn on interrupts again


;;; Initialise SyMonIII
;;; Initialise system variables as follows:
        LDA  #$FF
        STA  DELLO    ; delay time low byte
        STA  DELHI    ; high byte
        JSR  MONPROHILO ;prompt string buffer address pointer high and low byte
        STZ  ACCUM    ; ACCUMULATOR preset/result value
        STZ  XREG     ; X-REGISTER preset/result value
        STZ  YREG     ; Y-REGISTER preset/result value
        STZ  PREG     ; PROCESSOR STATUS REGISTER preset/result value
        STZ  OUTCNT   ; keystroke buffer 'read from' counter
        STZ  INCNT    ; keystroke buffer 'written to' counter
        LDA  #$7F
        STA  SREG     ; USER program/application STACK POINTER preset/result value
WARMST
        LDX  #$01     ; Set delay time
        JSR  SET      ; do short delay
        JSR  CR2      ; Send 2 CR,LF to terminal
;;; Send BIOS logo messages to terminal
        LDA  #$03     ; Send big PLUTO + "S/O/S BIOS/monitor (c)1990 B.Phelps" to terminal
        JSR  PROMPT
        JSR  CROUT    ; Send CR,LF to terminal
        JSR  MONPROHILO
        LDA  #$01     ; Send "Version mm.dd.yy" to terminal
        JSR  PROMPT
        JSR  CROUT    ; Send CR,LF to terminal
        LDA  #$02     ; Send "[CTRL-A] runs sub-assembler" to terminal
        JSR  PROMPT
        JSR  CR2      ; Send 2 CR,LF to terminal
        LDA  #$0B     ; Send "SyMon III" to terminal
        JSR  PROMPT

;
;
;**********************
;* SyMon III monitor  *
;* command input loop *
;**********************
;
MONITOR .proc
        STZ  LOKOUT   ;Disable ASCII HEX/DEC digit filter, (RDLINE subroutine uses this)
        JSR  CR2      ;Send 2 CR,LF to terminal
        JSR  MONPROHILO
        LDA  #$0C     ;Send "Monitor:" to terminal
        JSR  PROMPT
        JSR  BEEP     ;Send ASCII [BELL] to terminal
NMON
        LDX  #$FF     ;Initialize STACK POINTER
        TXS
        JSR  MONPROHILO ;Restore monitor prompt string buffer address pointer
                        ; in case a monitor command, user or an application changed it
        JSR  CR2    ;Send 2 CR,LF to terminal
        LDA  #'M'   ;Send "M" to terminal
        JSR  COUT
        LDA  #'-'   ;Send "-" to terminal
        JSR  COUT
CMON
        JSR  RDCHAR   ;Wait for keystroke: RDCHAR converts lower-case Alpha. to upper-case
        PHA           ;Save keystroke to STACK
        ASL           ;Multiply keystroke value by 2
        TAX           ;Get monitor command processor address from table MONTAB
        LDA  MONTAB,X ; using multiplied keystroke value as the index
        STA  COMLO    ;Store selected command processor address low byte
        INX
        LDA  MONTAB,X
        STA  COMHI    ;Store selected command processor address hi byte
        PLA           ;Restore keystroke from STACK: some command processors send keystroke to terminal
        JSR  DOCOM    ;Call selected monitor command processor as a subroutine
        JMP  NMON     ;LOOP back to NMON: command has been processed, go wait for next command
        .pend

DOCOM   .proc
        JMP  (COMLO)  ;Go process command then RETURN
        .pend

;
;
;******************************
;* Monitor command jump table *
;******************************
;
;List of monitor command processor addresses. These are indexed by ASCII keystroke values
; which have been filtered (lower case Alpha. converted to upper case) then multiplied by 2
;        command:     keystroke: Keystroke value:  Monitor command function:
MONTAB:
        .word  LISTER.RET      ;[BREAK]              $00 ([BREAK] keystroke is trapped by the IRQ service routine)
        .word  ASSEM    ;[CTRL-A]             $01  Call Sub-Assembler utility
        .word  ERR      ;[CTRL-B]             $02
        .word  ERR      ;[CTRL-C]             $03
        .word  DOWNLOAD ;[CTRL-D]             $04  Download data/program file (MS HYPERTERM use: paste-to-host)
        .word  ERR      ;[CTRL-E]             $05
        .word  ERR      ;[CTRL-F]             $06
        .word  ERR      ;[CTRL-G]             $07
        .word  ERR      ;[CTRL-H],[BACKSPACE] $08
        .word  ERR      ;[CTRL-I],[TAB]       $09
        .word  ERR      ;[CTRL-J],[LINEFEED]  $0A
        .word  ERR      ;[CTRL-K]             $0B
        .word  LISTER   ;[CTRL-L]             $0C  Disassemble from specified address
        .word  ERR      ;[CTRL-M],[RETURN]    $0D
        .word  ERR      ;[CTRL-N]             $0E
        .word  ERR      ;[CTRL-O]             $0F
        .word  ERR      ;[CTRL-P]             $10
        .word  ERR      ;[CTRL-Q]             $11
        .word  COLDSTART ;[CTRL-R]             $12  Restart same as power-up or RESET
        .word  ERR      ;[CTRL-S]             $13
        .word  ERR      ;[CTRL-T]             $14
        .word  ERR      ;[CTRL-U]             $15
        .word  ERR      ;[CTRL-V]             $16
        .word  WIPE     ;[CTRL-W]             $17  Clear memory ($0000-$7FFF) then restart same as power-up or COLDSTART
        .word  ERR      ;[CTRL-X]             $18
        .word  ERR      ;[CTRL-Y]             $19
        .word  ERR      ;[CTRL-Z]             $1A
        .word  ERR      ;[CTRL-[],[ESCAPE]    $1B
        .word  ERR      ;[CTRL-\]             $1C
        .word  ERR      ;[CTRL-]]             $1D
        .word  ERR      ;                     $1E
        .word  ERR      ;                     $1F
        .word  SPC2     ;[SPACE]              $20  Send [SPACE] to terminal (test for response, do nothing else)
        .word  ERR      ; !                   $21
        .word  ERR      ; "                   $22
        .word  ERR      ; #                   $23
        .word  ERR      ; $                   $24
        .word  ERR      ; %                   $25
        .word  ERR      ; &                   $26
        .word  ERR      ; '                   $27
        .word  ERR      ; (                   $28
        .word  ERR      ; )                   $29
        .word  ERR      ; *                   $2A
        .word  ERR      ; +                   $2B
        .word  ERR      ; ,                   $2C
        .word  ERR      ; -                   $2D
        .word  ERR      ; .                   $2E
        .word  ERR      ; /                   $2F
        .word  ERR      ; 0                   $30
        .word  ERR      ; 1                   $31
        .word  ERR      ; 2                   $32
        .word  ERR      ; 3                   $33
        .word  ERR      ; 4                   $34
        .word  ERR      ; 5                   $35
        .word  ERR      ; 6                   $36
        .word  ERR      ; 7                   $37
        .word  ERR      ; 8                   $38
        .word  ERR      ; 9                   $39
        .word  ERR      ; :                   $3A
        .word  ERR      ; ;                   $3B
        .word  ERR      ; <                   $3C
        .word  ERR      ; =                   $3D
        .word  ERR      ; >                   $3E
        .word  ERR      ; ?                   $3F
        .word  ERR      ; @                   $40
        .word  ERR      ; A                   $41
        .word  ERR      ; B                   $42
        .word  ERR      ; C                   $43
        .word  MDUMP    ; D                   $44
        .word  ERR      ; E                   $45
        .word  MFILL    ; F                   $46  Fill a specified memory range with a specified value
        .word  GO       ; G                   $47  Begin program code execution at a specified address
        .word  ERR      ; H                   $48
        .word  ERR      ; I                   $49
        .word  ERR      ; J                   $4A
        .word  ERR      ; K                   $4B
        .word  ERR      ; L                   $4C
        .word  MOVER    ; M                   $4D  Copy a specified memory range to a specified target address
        .word  ERR      ; N                   $4E  (Reserved: NEXT/NOTHING command)
        .word  ERR      ; O                   $4F
        .word  ERR      ; P                   $50
        .word  QUERY    ; Q                   $51  Display list of useful system subroutines
        .word  ERR      ; R                   $52
        .word  SRG      ; S                   $53  Examine/change STACK POINTER preset/result
        .word  PRINT_DATE_AND_TIME      ; T                   $54
        .word  ERR ;UPLOAD   ; U                   $55  Upload data/program file
        .word  ERR      ; V                   $56
        .word  WATCH    ; W                   $57  Monitor a specified memory location's contents until a key is struck
        .word  ERR      ; X                   $58
        .word  ERR      ; Y                   $59
        .word  PUT_DATE_AND_TIME      ; Z                   $5A
        .word  ERR      ; [                   $5B
        .word  ERR      ; \                   $5C
        .word  ERR      ; ]                   $5D
        .word  ERR      ; ^                   $5E
        .word  ERR      ; _                   $5F
        .word  ERR      ; `                   $60
;
;
;*************************************
;* IRQ/BRK Interrupt service routine *
;*************************************
;
INTERRUPT
        JMP  (IRQVECTOR)

DOINTERRUPT
        PLA                 ;Get processor status register from stack
        PHA                 ;Push it back for RTI
        STA  STATUSREGISTER ;Store processor status register for BRK ISR

        PHX                 ;Save X-REGISTER
        PHY                 ;Save Y-REGISTER
        PHA                 ;Save ACCUMULATOR
        JSR  ACIA_INTERRUPT
        JSR  VIAINTERRUPT
        JSR  BRK_INTERRUPT
        PLA
        PLY
        PLX
        RTI

ACIA_INTERRUPT
        LDA  SIOSTAT    ;Read 6551 ACIA status register
        AND  #ACIAMASK  ;Isolate bits. bit 7: Interrupt has occured and bit 3: receive data register full
        EOR  #ACIAMASK  ;Invert state of both bits
        BNE  END_ACIA_INTERRUPT   ;GOTO END_ACIA_INTERRUPT IF bit 7 = 1 OR bit 3 = 1: no valid data in receive data register
        LDA  SIODAT     ; ELSE, read 6551 ACIA receive data register
        LDX  INCNT      ; ELSE, Store keystroke in keystroke buffer address
        STA  KEYBUFF,X  ;  indexed by INCNT: keystroke buffer input counter
        INC  INCNT      ;Increment keystroke buffer input counter

END_ACIA_INTERRUPT
        RTS

;Handle interrupts from VIA
;
VIAINTERRUPT
        LDA  VIAIFR
        AND  VIAIER
        STA  VIATEMP
        BBS  VIAIFRIRQ,VIATEMP,HANDLEVIAINTERRUPT
        RTS

;HANDLEVIAINTERRUPT
;Priority is Timer 1 and then Timer 2
;
HANDLEVIAINTERRUPT
        BBR  VIATIMER1MASK,VIATEMP,CHECKVIATIMER2   ;GOTO CHECKVIATIMER2 if Timer 1 didn't cause an interrupt
; HANDLE TIMER1 INTERRUPT

CHECKVIATIMER2
        BBR  VIATIMER2MASK,VIATEMP,ENDIRQ           ;GOTO ENDIRQ if Timer 2 didn't cause an interrupt
; HANDLE TIMER2 INTERRUPT
        
ENDIRQ
        RTS         ;Timer 2 interrupt handled so exit ISR

        BRKMASK = %00010000   ;BRK mask in processor status register
        STACKPTR = $103       ;Stacked processor status register

BRK_INTERRUPT
        LDA  STATUSREGISTER ;Read processor status register
        AND  #BRKMASK       ;Isolate BREAK bit
        BNE  BRKINSTRUCTION ;GOTO BRKINSTRUCTION IF bit = 1, ie BRK instruction
        RTS                 ; ELSE, RETURN from BRK instruction handler
BRKINSTRUCTION
        PLA                 ; ELSE, Remove return address low byte to ISR
        PLA                 ; ELSE, Remove return address high byte to ISR
        PLA                 ; ELSE, restore ACCUMULATOR to pre-interrupt condition
        STA  ACCUM          ;Save in ACCUMULATOR preset/result
        PLA                 ;Pull PROCESSOR STATUS REGISTER from STACK
        STA  PREG           ;Save in PROCESSOR STATUS preset/result
        STX  XREG           ;Save X-REGISTER
        STY  YREG           ;Save Y-REGISTER
        TSX
        STX  SREG           ;Save STACK POINTER
        JSR  CROUT          ;Send CR,LF to terminal
        PLA                 ;Pull RETURN address from STACK then save it in INDEX
        STA  INDEX          ;Low byte
        PLA
        STA  INDEXH         ;High byte
        JSR  CR2            ;Send CR,LF to terminal two times
        JSR  DISLINE        ;Disassemble then display instruction at address pointed to by INDEX
        LDA  #$00           ;Clear all PROCESSOR STATUS REGISTER bits
        PHA
        PLP
        LDX  #$FF           ;Set STACK POINTER to $FF
        TXS
        LDA  #$7F           ;Set STACK POINTER preset/result to $7F
        STA  SREG
        LDA  INCNT          ;Remove keystrokes from keystroke input buffer
        STA  OUTCNT
        JMP  MONITOR.NMON   ;Done interrupt service process, re-enter monitor

;

TIMER1TXT
        .text "timer1"
        .byte $0a, $0d, $00

TIMER1
        PHA
; DO SOMETHING
        LDA  #<TIMER1TXT
        STA  INDEX
        LDA  #>TIMER1TXT
        STA  INDEXH
        JSR  PROMPT2

        PLA
        RTS

TIMER2TXT
        .text "timer2"
        .byte $0a, $0d, $00

TIMER2
        PHA
; DO SOMETHING
        LDA  #<TIMER2TXT
        STA  INDEX
        LDA  #>TIMER2TXT
        STA  INDEXH
        JSR  PROMPT2

        PLA
        RTS

HANDB1
        .text "HANDSHAKEB1"
        .byte $0a, $0d, $00

HANDSHAKECONTROLB1
        PHA
; DO SOMETHING
        LDA  #<HANDB1
        STA  INDEX
        LDA  #>HANDB1
        STA  INDEXH
        JSR  PROMPT2

        PLA
        RTS

HANDB2
        .text "HANDSHAKEB2"
        .byte $0a, $0d, $00

HANDSHAKECONTROLB2
        PHA
; DO SOMETHING
        LDA  #<HANDB2
        STA  INDEX
        LDA  #>HANDB2
        STA  INDEXH
        JSR  PROMPT2

        PLA
        RTS

SHIFT
        .text "SHIFT"
        .byte $0a, $0d, $00

SHIFTREGISTER
        PHA
; DO SOMETHING
        LDA  #<SHIFT
        STA  INDEX
        LDA  #>SHIFT
        STA  INDEXH
        JSR  PROMPT2

        PLA
        RTS

HANDA1
        .text "HANDSHAKEA1"
        .byte $0a, $0d, $00

HANDSHAKECONTROLA1
        PHA
; DO SOMETHING
        LDA  #<HANDA1
        STA  INDEX
        LDA  #>HANDA1
        STA  INDEXH
        JSR  PROMPT2

        PLA
        RTS

HANDA2
        .text "HANDSHAKEA2"
        .byte $0a, $0d, $00

HANDSHAKECONTROLA2
        PHA
; DO SOMETHING
        LDA  #<HANDA2
        STA  INDEX
        LDA  #>HANDA2
        STA  INDEXH
        JSR  PROMPT2

        PLA
        RTS

;
;
;***********************
;* S/O/S Sub-Assembler *
;*        v3.6         *
;* (c)1990 By B.Phelps *
;***********************
;
;Sub-assembler main loop
;
ASSEM   .proc
        JSR  CR2      ;Send 2 CR,LF to terminal
        JSR  ASMPROHILO ;Point to prompt strings (assembler strings)
        LDA  #$12     ;Send "S/O/S sub-assembler v3.6" to terminal
        JSR  PROMPT
        JSR  CR2      ;Send 2 CR,LF to terminal
        JSR  REORIG   ;Request origin address input from terminal (working address)
NEWLIN:
        JSR  CROUT    ;Send CR,LF to terminal
NLIN:
        JSR  DOLLAR   ;Send "$" to terminal
        JSR  PRINDX   ;Display current working address
        LDA  #$2D     ;Send "-" to terminal
        JSR  COUT
        JSR  SPC2     ;Send 2 [SPACE] to terminal
REENTR:
        LDX  #$03     ;Initialize mnemonic keystroke counter
ENTER:
        JSR  RDCHAR   ;Request a keystroke, convert lower-case Alpha. to upper-case
        CMP  #$1B     ;GOTO ANOTESC IF keytroke <> [ESCAPE]
        BNE  ANOTESC
        CMP  MONITOR.NMON     ;Done ASSEM, GOTO NMON: go back to monitor
ANOTESC:
        CMP  #$20     ;GOTO NOTSPC IF keytroke <> [SPACE]
        BNE  NOTSPC
        JSR  SAVLST   ; ELSE, save current working address
        LDA  #$0D     ;Send [RETURN] to terminal
        JSR  COUT
        JSR  DISLINE  ;Disassemble byte(s) found at working address, calculate next working address
        BRA  NLIN     ;LOOP back to NLIN
NOTSPC:
        CMP  #$2E     ;GOTO DIRECTV IF keystroke = "."
        BEQ  DIRECTV
NEM:
        CMP  #$5B     ; ELSE, GOTO TOOHI IF keystroke >= ("Z"+1)
        BCS  TOOHI
        CMP  #$41     ; ELSE, GOTO NOTLESS IF keystroke >= "A"
        BCS  NOTLESS
TOOHI:
        JSR  BEEP     ; ELSE, send [BELL] to terminal
        BRA  ENTER    ;LOOP back to ENTER
NOTLESS:
        STA  INBUFF-1,X ;Store keystroke in INBUFF indexed by mnemonic keystroke counter
        JSR  COUT     ;Send keystroke to terminal
        DEX           ;Decrement mnemonic keystroke counter
        BNE  ENTER    ;LOOP back to ENTER IF mnemonic keystroke counter <> 0
        LDY  #$01     ; ELSE, initialize mnemonic counter
RDLOOP2:
        LDA  MTAB,X   ;GOTO SKIP3 IF indexed character in MTAB <> keystroke in INBUFF+2
        CMP  INBUFF+2
        BNE  SKIP3
        INX           ; ELSE, increment mnemonic table index
        LDA  MTAB,X   ;GOTO SKIP2 IF indexed character in MTAB <> keystroke in INBUFF+1
        CMP  INBUFF+1
        BNE  SKIP2
        INX           ; ELSE, increment mnemonic table index
        LDA  MTAB,X   ;GOTO SKIP1 IF indexed character in MTAB <> keystroke in INBUFF
        CMP  INBUFF
        BNE  SKIP1
        TYA           ; ELSE, multiply mnemonic counter by 2: mnemonic handler jump table index
        CLC
        ASL
        TAX
        LDA  JTAB,X   ;Read indexed mnemonic handler address from jump table,
        STA  COMLO    ; store address at COMLO,COMHI
        LDA  JTAB+1,X
        STA  COMHI
        JSR  SAVLST   ;Save current working address
        JMP  (COMLO)  ;GOTO mnemonic handler
;Abort compare against current indexed mnemonic, point to next mnemonic in mnemonic table
SKIP3:
        INX           ;Increment mnemonic table index
SKIP2:
        INX           ;Increment mnemonic table index
SKIP1:
        INX           ;Increment mnemonic table index
        INY           ;Increment mnemonic counter
        CPY  #$46     ;LOOP back to RDLOOP2 IF mnemonic counter <> $46 (end of mnemonic table)
        BNE  RDLOOP2
        JSR  BEEP     ; ELSE, send [BELL] to terminal: user entered an invalid mnemonic
        LDA  #$08     ;Send 3 [BACKSPACE] to terminal
        JSR  COUT3
        BRA  REENTR   ;LOOP back to REENTER
;Process directives
DIRECTV:
        JSR  COUT     ;Send last keystroke (".") to terminal
        JSR  RDCHAR   ;Request a keystroke, convert lower-case Alpha. to upper-case
        LDX  #$00     ;Initialize directive table index
DIRTST:
        CMP  DIRTAB,X ;GOTO DIROK IF keystroke = indexed directive from DIRTAB
        BEQ  DIROK
        INX           ; ELSE, increment directive table index
        CPX  #$0F     ;LOOP back to DIRTST IF directive table index <> $0F (end of directive table)
        BNE  DIRTST
        JSR  BEEP     ; ELSE, send [BELL] to terminal: user entered an invalid directive
        JMP  NEWLIN   ;LOOP back to NEWLIN
DIROK:
        CLC           ;multiply directive table index by 2: directive handler jump table index
        TXA
        ASL
        TAX
        LDA  DJTAB,X  ;Read indexed directive handler address from jump table,
        STA  COMLO    ; store address at COMLO,COMHI
        LDA  DJTAB+1,X
        STA  COMHI
        JSR  DODIR    ;Call directive handler as a subroutine
        JMP  NEWLIN   ;LOOP back to NEWLIN
DODIR:
        JMP  (COMLO)  ;GOTO directive handler
        .pend

;
;Assembler directive handlers:
;
;
;[.B] BYTE directive subroutine: Request HEX byte(s) input from terminal, store byte(s) in working memory.
; This loops until [RETURN] is struck when no HEX digits have been entered
ABYTE   .proc
        JSR  SAVLST   ;Save current working address
        LDA  #$0F     ;Send "Byte: " to terminal
        JSR  PROMPT
BYLOOP:
        JSR  SPC2     ;Send 2 [SPACE] to terminal
        JSR  HEXIN2   ;Request 1 or 2 HEX digit (data byte) input from terminal
        LDX  SCNT     ;GOTO BYOK IF any digits were entered
        BNE  BYOK
        RTS           ; ELSE, done ABYTE directive, RETURN
BYOK:
        LDX  #$00     ;Store entered byte at current working address
        STA  (INDEX,X)
        JSR  INCNDX   ;Increment working address
        BRA  BYLOOP   ;LOOP back to BYLOOP
        .pend

;
;
;[.I] KEYCONV directive subroutine: display HEX equivalent of a keystroke to terminal
KEYCONV:
        JSR  CHIN     ;Request a keystroke from terminal
        PHA           ;Save keystroke on STACK
        JSR  PRASC    ;Send keystroke to terminal IF printable ASCII, ELSE send "."
        LDA  #$3D     ;Send "=" to terminal
        JSR  COUT
        JSR  DOLLAR   ;Send "$" to terminal
        PLA           ;Restore keystroke value from STACK
        JMP  PRBYTE   ;Send ASCII HEX representation of keystroke to terminal then done, RETURN
;
;[.L] LIST directive subroutine: list (disassemble) 21 instructions
LIST:
        LDA  #$14     ;Send "List: " to terminal
        JSR  PROMPT
        JSR  SAVLST   ;Save current working address
        JSR  HEXIN4   ;Request 1 to 4 HEX digit address input from terminal
        JSR  CROUT    ;Send CR,LF to terminal
        LDA  SCNT     ;GOTO LSTNEW IF any digits were entered
        BNE  LSTNEW
        LDA  TEMP2    ; ELSE, make working address = last specified origin address:
        STA  INDEX    ;  list from last specified origin address
        LDA  TEMP2H
        STA  INDEXH
LSTNEW:
        LDA  #$15     ;Initialize instruction count: number of instructions to list = 21 ($15)
        STA  TEMP
DISLOOP:
        JSR  DISLINE  ;List (disassemble) one instruction
        DEC  TEMP     ;Decrement instruction count
        BNE  DISLOOP  ;LOOP back to DISLOOP IF instruction count <> 0
MORLOOP:
        JSR  CHIN     ; ELSE, request a keystroke from terminal
        CMP  #$0D     ;GOTO MORDIS IF keystroke <> [RETURN]
        BNE  MORDIS
        LDA  IDX      ; ELSE, make working address = saved working address:
        STA  INDEX    ;  restore working address to pre-LIST directive condition
        LDA  IDY
        STA  INDEXH
        RTS           ;Done LIST directive, RETURN
MORDIS:
        CMP  #$20     ;LOOP back to LSTNEW IF keystroke <> [SPACE]
        BNE  LSTNEW
        JSR  DISLINE  ;List (disassemble) one instruction
        BRA  MORLOOP  ;LOOP back to MORLOOP
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
