johangroth/PLUTO/(commit log)

2016-10-07 Added datasheets for IDE interface. TaliForth source added. KiCad documentation added. Some ide assembler routines added (not tested). VT100 escape sequences added.
    [Tali Forth Instructions.ods]
2016-10-27 Removed hardcoded addresses to subroutines printed out by Q command. Added prototype for an IDE driver. Added datasheets for RTC.
2017-02-14 New version of Tali Forth
    [Tali Forth Instructions.ods]
2017-02-14 Added IDE interface schema
    [IDE_interface.dsn, IDE_interface.kicad_pcb, IDE_interface.sch]
2017-02-15 remove never used schematics.
    [pluto.kicad_pcb, pluto.sch]
2017-02-15 Added TaliForth without .git directory
    [Tali Forth Instructions.ods]
2017-02-21 Moved all assembler files to one directory.
2017-02-21 Tali kernel removed from assembly chain.
2017-03-07 Removed TaliForth
    [Tali Forth Instructions.ods]
2017-03-23 Added vt100 terminal code and schematics for PLUTO SBC board.
    [pluto.kicad_pcb, pluto.sch]
2017-03-24 Changed names of IO select lines.
    [IDE_interface.sch, pluto.sch]
2017-03-24 Renamed IDE directory to HW
    [IDE_interface.dsn, IDE_interface.kicad_pcb, IDE_interface.sch, pluto.kicad_pcb, pluto.sch]
2017-03-24 Started to make the schematics for pluto main board using multiple sheets.
    [_saved_cpu_rom_rav.sch, acia_max232.sch, address_decoding_and_support.sch, cpu_rom_ram.sch, cpu_rom_rav.sch, pluto.kicad_pcb, pluto.sch, power_and_expansion.sch]
2017-03-25 PLUTO SBC with RTC schematics done.
    [acia_max232.sch, address_decoding_and_support.sch, cpu_rom_ram.sch, pluto.sch, power_and_expansion.sch, via_rtc.sch]
2017-03-25 Via connectors.pro? Commited and pushed just in case.
2017-03-25 The PCB layout editor doesn't like 7805's footprint.
    [_saved_cpu_rom_ram.sch, acia_max232.sch, address_decoding_and_support.sch, cpu_rom_ram.sch, power_and_expansion.sch, via_rtc.sch]
2017-03-25 Removed old Pluto schematics.
    [pluto.kicad_pcb, pluto.sch]
2017-03-25 Renamed multisheet schematics to SBC
    [_saved_cpu_rom_ram.sch, _saved_cpu_rom_rav.sch, acia_max232.sch, address_decoding_and_support.sch, cpu_rom_ram.sch, cpu_rom_rav.sch, pluto.kicad_pcb, pluto.sch]
2017-03-26 Some changes to the schematics.
    [_saved_cpu_rom_ram.sch, acia_max232.sch, address_decoding_and_support.sch, cpu_rom_ram.sch, pluto.sch, power_and_expansion.sch, via_rtc.sch]
2017-03-28 Added a couple of procedure assembler directives. ctags file added
2017-03-28 Connected all relevant I/O select signals to expansion port.
    [power_and_expansion.sch]
2017-03-29 Corrected some Z80 -> 65C02 errors.
    [basic_ide_routines.asm]
2017-04-03 New MB design. Includes RTC. New IDE design.
    [IDE_interface-B.Cu.gbr, IDE_interface-B.Mask.gbr, IDE_interface-B.SilkS.gbr, IDE_interface-Edge.Cuts.gbr, IDE_interface-F.Cu.gbr, IDE_interface-F.Mask.gbr, IDE_interface-F.SilkS.gbr, IDE_interface.drl]
2017-04-04 Added DS1511 code. Code in 65816 assembler so conversion is needed.
2017-04-19 Added original xmodem code some datasheets and a C02Monitor.
    [via_connectors.sch, via_rts.sch]
2017-04-19 Fixed pluto kernel (SyMon, command address table had been corrupted).
    [cpu_rom_ram.sch, via_rtc.sch]
2017-04-20 Include xmodem in the assembly list.
2017-04-29 Updates to pcb and monitor.
    [IDE_interface.dsn, IDE_interface.kicad_pcb, IDE_interface.sch, acia_max232.sch, address_decoding_and_support.sch, power_and_expansion.sch, via_rtc.sch]
2017-04-29 Move dicoupling capacitators as close the chips as possible.
    [acia_max232.sch, address_decoding_and_support.sch, cpu_rom_ram.sch, power_and_expansion.sch]
2017-05-04 Schema changes to SBC
    [acia_max232.sch, address_decoding_and_support.sch, cpu_rom_ram.sch, via_rtc.sch]
2017-05-05 BinToHex added. Updates to SBC schema. Added ISR for VIA (still WIP).
    [cpu_rom_ram.sch]
2017-05-08 Improved VIA interrupt handling. Input of address is broken.
    [pluto_kernel.asm, rtc.asm]
2017-05-09 Interrupt vector is stored in bash302 and ISR has been updated accordingly.
2017-05-10 Begun to add VIA interrupt code. Some formatting of comments.
2017-05-10 Added acia.asm. Guarded interrupt vector setup with sei/cli.
2017-05-10 Trying to fix BRK ISR after code review by BigDumbDinosaur.
    [pluto_kernel.asm, via.asm]
2017-05-10 More improvements to ISR. xmodem doesn't handle download anymore.
    [pluto_kernel.asm, xmodem.asm]
2017-05-15 New board layout. WIP
    [acia_max232.sch, address_decoding_and_support.sch, pluto.dsn, pluto.kicad_pcb, power_and_expansion.sch, via_rtc.sch]
2017-05-22 PUT, GET and PRINT_DATE_AND_TIME works. PUT has no input routine yet.
2017-05-24 asm4doxy and assembler book.
2017-05-24 assembler book added.
2017-05-24 New SBC PCB. Started to split pluto_kernel.asm into bios, monitor and miniassembler/disassembler. Various other updates.
    [_saved_cpu_rom_ram.sch, acia_max232.sch, address_decoding_and_support.sch, pluto.dsn, pluto.kicad_pcb, power_and_expansion.sch, via_rtc.sch]
2017-05-24 Removed KiCad documentation
2017-05-30 New board layout with decoupling caps in the right place. Updates to the RTC code (IRQ still doesn't work).
    [_saved_cpu_rom_ram.sch, acia_max232.sch, address_decoding_and_support.sch, cpu_rom_ram.sch, pluto.dsn, pluto.kicad_pcb, power_and_expansion.sch, via_rtc.sch]
2017-06-03 New schema. Adding a VIA and sound chip.
    [acia_max232.sch, address_decoding_and_support.sch, audio.sch, cpu_rom_ram.sch, pluto.sch, power_and_expansion.sch, via_rtc.sch]
2017-06-03 Moved IDE schematics (WIP) into pluto.
    [acia_max232.sch, address_decoding_and_support.sch, audio.sch, cpu_rom_ram.sch, ide.sch, pluto.sch, power_and_expansion.sch, via_rtc.sch]
2017-06-03 Added IDE interface to PLUTO board.
    [IDE16bit.sch, acia_max232.sch, address_decoding_and_support.sch, audio.sch, cpu_rom_ram.sch, ide.sch, pluto.sch, power_and_expansion.sch]
2017-06-06 Connected most hierarchical labels between the sheets. Added a connector to AY IO port.
    [IDE16bit.sch, acia_max232.sch, address_decoding_and_support.sch, audio.sch, cpu_rom_ram.sch, pluto.sch, power_and_expansion.sch, via_rtc.sch]
2017-06-07 Still no VCC net in PCBnew.
    [IDE16bit.sch, acia_max232.sch, address_decoding_and_support.sch, audio.sch, cpu_rom_ram.sch, pluto.kicad_pcb, pluto.sch, power_and_expansion.sch]
2017-06-08 New PCB layout. Added datasheet for AY-3-8912 and LM386.
    [address_decoding_and_support.sch, audio.sch, cpu_rom_ram.sch, pluto.kicad_pcb, pluto.sch, power_and_expansion.sch, via_rtc.sch]
2017-06-12 Autorouted PCB.
    [pluto.dsn, pluto.kicad_pcb, power_and_expansion.sch]
2017-06-13 Added some silk screen text.
    [pluto.kicad_pcb]
2017-06-16 Moved seldom used files to WIP. Added C02BIOS. Added gerbers for new PCB (sent to manufacturer).
    [pluto-B.Cu.gbr, pluto-B.Mask.gbr, pluto-B.SilkS.gbr, pluto-Edge.Cuts.gbr, pluto-F.Cu.gbr, pluto-F.Mask.gbr, pluto-F.SilkS.gbr, pluto.drl]
2017-07-03 Schema is now Alpha.
    [IDE16bit.sch, acia_max232.sch, address_decoding_and_support.sch, audio.sch, cpu_rom_ram.sch, pluto.sch, power_and_expansion.sch, via_rtc.sch]
2017-07-06 Made sure all the not used flip's input pins are grounded. Added original z80 ide code. Cosmetic changes to ide routine.
    [IDE16bit.sch, address_decoding_and_support.sch, pluto.sch]
2017-07-10 Added path to 65xx library
    [IDE16bit.sch, acia_max232.sch, address_decoding_and_support.sch, audio.sch, cpu_rom_ram.sch, pluto.sch, power_and_expansion.sch, via_rtc.sch]
2017-07-10 Added ISR soft vector table initialisation.
    [acia_max232.sch]
2017-07-10 Initialisation routines developed. New library preferences to KiCad schema. Broken though but it doesn't matter as the PCB has been manufactured. Schema and PCB doesn't match 100% (e.g. 74HCT74 unuse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
    [IDE16bit.sch, acia_max232.sch, address_decoding_and_support.sch, audio.sch, cpu_rom_ram.sch, pluto.sch, power_and_expansion.sch, via_rtc.sch]
2017-07-11 Break interrupt service routine done.
2017-08-09 Small changes to schematics. Futher development of BIOS.
    [IDE16bit.sch, acia_max232.sch, address_decoding_and_support.sch, audio.sch, cpu_rom_ram.sch, pluto.sch, power_and_expansion.sch, via_rtc.sch]
2017-08-15 Update of test program to test both VIA.
    [cpu_rom_ram.sch]
2017-08-15 Use correct assembler flags for Pluto bios. Deleted redundant include file. Minor changes to bios.asm.
    [bios.asm]
2017-08-16 Missing label in bios.asm. Hi low pointer reversed in zp.inc.
    [bios.asm]
2017-08-18 Got interrupt driven transmission working again (right command register bit pattern helps). Started making screen manipulation routines.
2017-08-23 Fixed bug in backspace proc.
    [bios.asm]
2017-11-02 Include ide_routines.asm when assembling pluto rom file.
2017-11-21 Fixed prout so it can print string longer than 256 bytes. Changed added comments here and there.
    [acia.asm, ascii_to_bin.asm, bin_to_ascii.asm, bios.asm, main.asm, utils.asm]
2017-11-21 Fixed indentation and added some comments.
    [bios.asm]
2017-11-21 Fixed indentation and added some comments again.
    [bios.asm]
2017-12-11 Small changes to comments.
    [cpu_rom_ram.sch]
2017-12-25 Changed all TTLs to HC family.
    [IDE16bit.sch, address_decoding_and_support.sch]
2018-01-07 Using ascii_to_bin but there is a bug. ABC gets converted to CBC, ie last character becomes the first character.
    [ascii_to_bin.asm, bios.asm]
2018-01-12 Converted code to lower case.
2018-01-13 Include all assembler files in the make file.
2018-01-18 Fixed bug in fill subroutine.
    [monitor.asm]
2018-04-20 Restructed project
    [IDE16bit.sch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]
2018-05-12 Input of day of month, month works. Validation of year doesn't.
    [ascii_to_bin.asm, bcd_bin_utils.asm, bios.asm, main.asm, monitor.asm, rtc.asm, via.asm]
2019-07-06 Added dis-assembler. Removed files that was never needed. Updates to schematics files due to upgrade to KiCad 5.1.
    [IDE16bit-2018-09-30-12-11-44.sch, acia_max232-2018-09-30-12-11-44.sch, address_decoding_and_support-2018-09-30-12-11-44.sch, audio-2018-09-30-12-11-44.sch, cpu_rom_ram-2018-09-30-12-11-44.sch, pluto-2018-09-30-12-11-44.sch, power_and_expansion-2018-09-30-12-11-44.sch, power_and_expansion.sch]
2019-07-07 Added some decimal output routines. Fixed tags files and removed ctags (atom handles tags itself). Some documentation updates.
    [bin_to_ascii.asm, bios.asm]
